aelbouhi0131-lang/BETABAKE_REV1.0/PCB/README.txt

# README – PCB Files

This folder contains two PCB versions

1. Routed PCB – The first PCB is the version I was working on, so I placed it here. However, it still contains some routing errors that need to be corrected.

2. PCB Before Routing – This is my copy of the PCB before routing. If you prefer to start from scratch, you can use this version and do the routing yourself.
