aelbouhi0131-lang/BETABAKE_REV1.0/BetaBake_REV_1.0_DRAFTSMAN.pdf

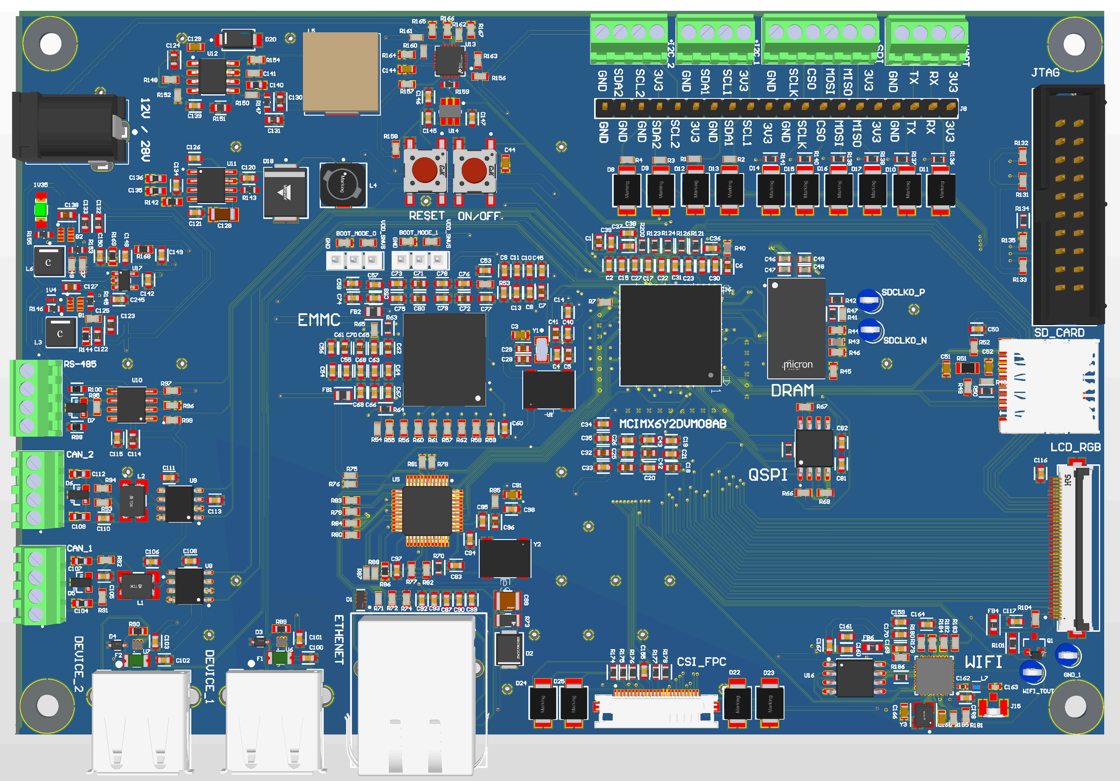
[picture p8: page 1]
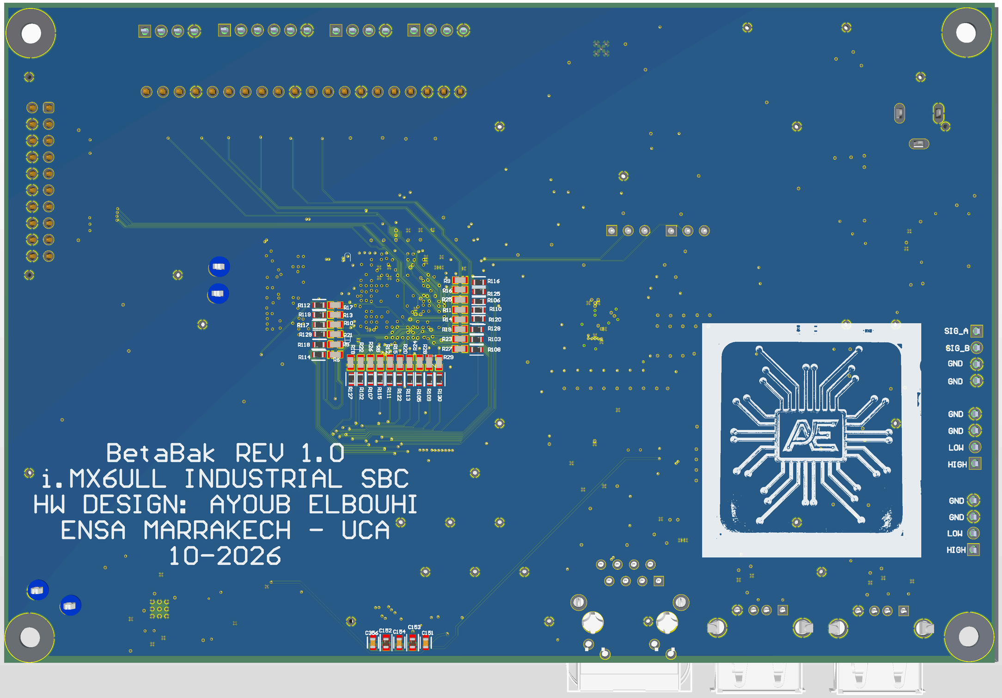
[picture p9: page 2]

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
TITLE

## TOP_LAYER

2

1

1

2

TITLE

## INNER_LAYER_1

2

1

1

2

TITLE

## PWR_LAYER

2

1

1

2

TITLE

## INNER_LAYER_2

2

1

1

2

TITLE

## BOTTOM_LAYER

2

1

1

2

Layer Stack Legend
Material

Total thickness: 1.63mm

Layer Top Overlay | ThicknessDielectric MaterialType
Gerber
GTO
GTS

TITLE

Surface MaterialTop Solder | 0.03mmSM-001
| 0.02mm
| 0.04mm
| 0.07mmPP-006
| 0.07mmPP-006
| 0.04mm
| 0.23mmCore-027

PbSn
CF-004
Prepreg
Prepreg
CF-004
Core
CF-004
Prepreg
Prepreg
CF-004
Core
CF-004
Prepreg
Prepreg
CF-004
Core
CF-004
Prepreg
Prepreg
CF-004
PbSn
Surface MaterialBottom Solder

Top Surface Finish
USB 2.0 (90 Diff) DDR3 Data (50-100)

GND (Top Layer high-speed return paths)

DDR3 Fly-by Routing (Address, Command, Control), QSPI Flash (Clk, IO)0.04mm 0.07mmPP-006
0.07mmPP-006
0.04mm
0.23mmCore-027
0.04mm
0.07mmPP-006
0.07mmPP-006
0.04mm
0.23mmCore-027
0.04mm
0.07mmPP-006
0.07mmPP-006
0.04mm
0.02mm
0.03mmSM-001

Int4 PWR

Int5 GND (Shielding between L4 and L6)

Int6 eMMC High-Speed Data Lines (8-bit bus), SDIO/peripherals

Int7 GND

Escapes, non-critical tracks, decoupling capacitor vias Bottom Surface Finish

Bottom Overlay

Legend
Solder Mask
Surface Finish
Signal
Dielectric
Dielectric
Internal PlaneGP1
Dielectric
Signal
Dielectric
Dielectric
Signal
Dielectric
Signal
Dielectric
Dielectric
Signal
Dielectric
Internal PlaneGP2
Dielectric
Dielectric
Signal
Surface Finish
Solder Mask
Legend

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
