aelbouhi0131-lang/BETABAKE_REV1.0/Images/3D/IMAGES ALTIUM/BetaBake_REV_1.0.png

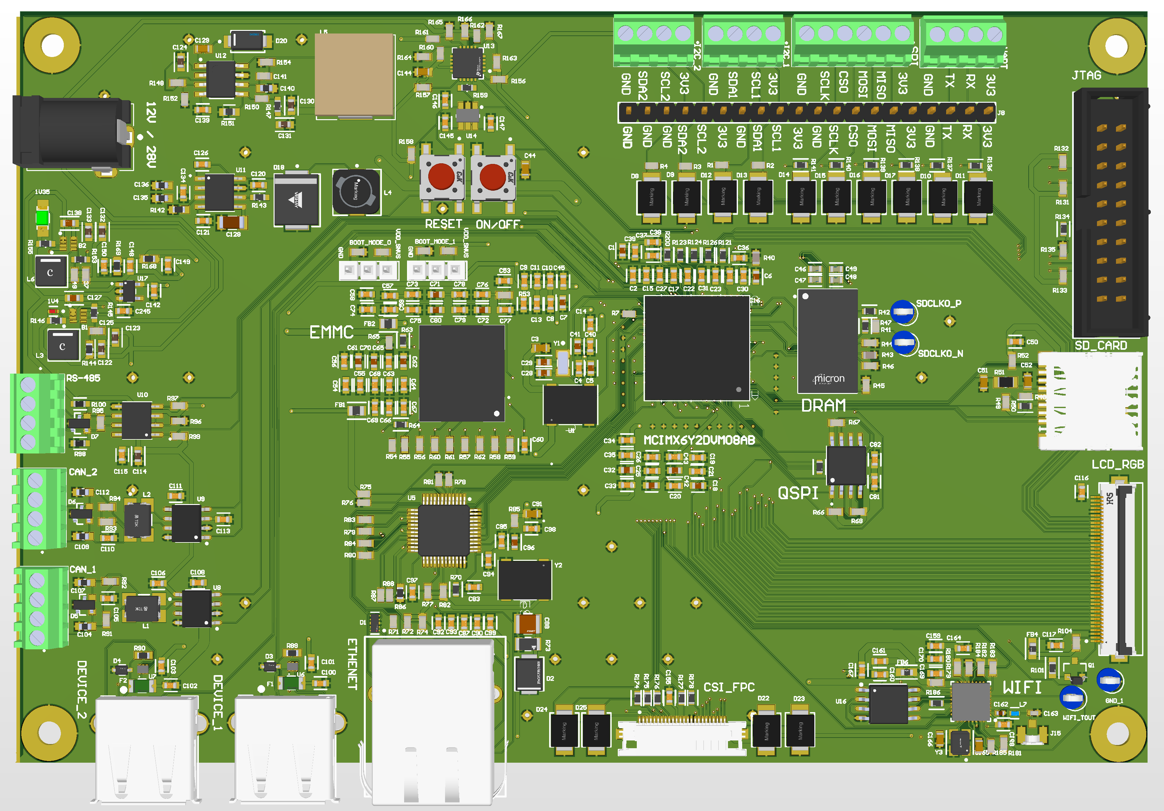
Images/3D/IMAGES ALTIUM/BetaBake_REV_1.0.png
