aelbouhi0131-lang/BETABAKE_REV1.0/BetaBake_REV_1.0.pdf

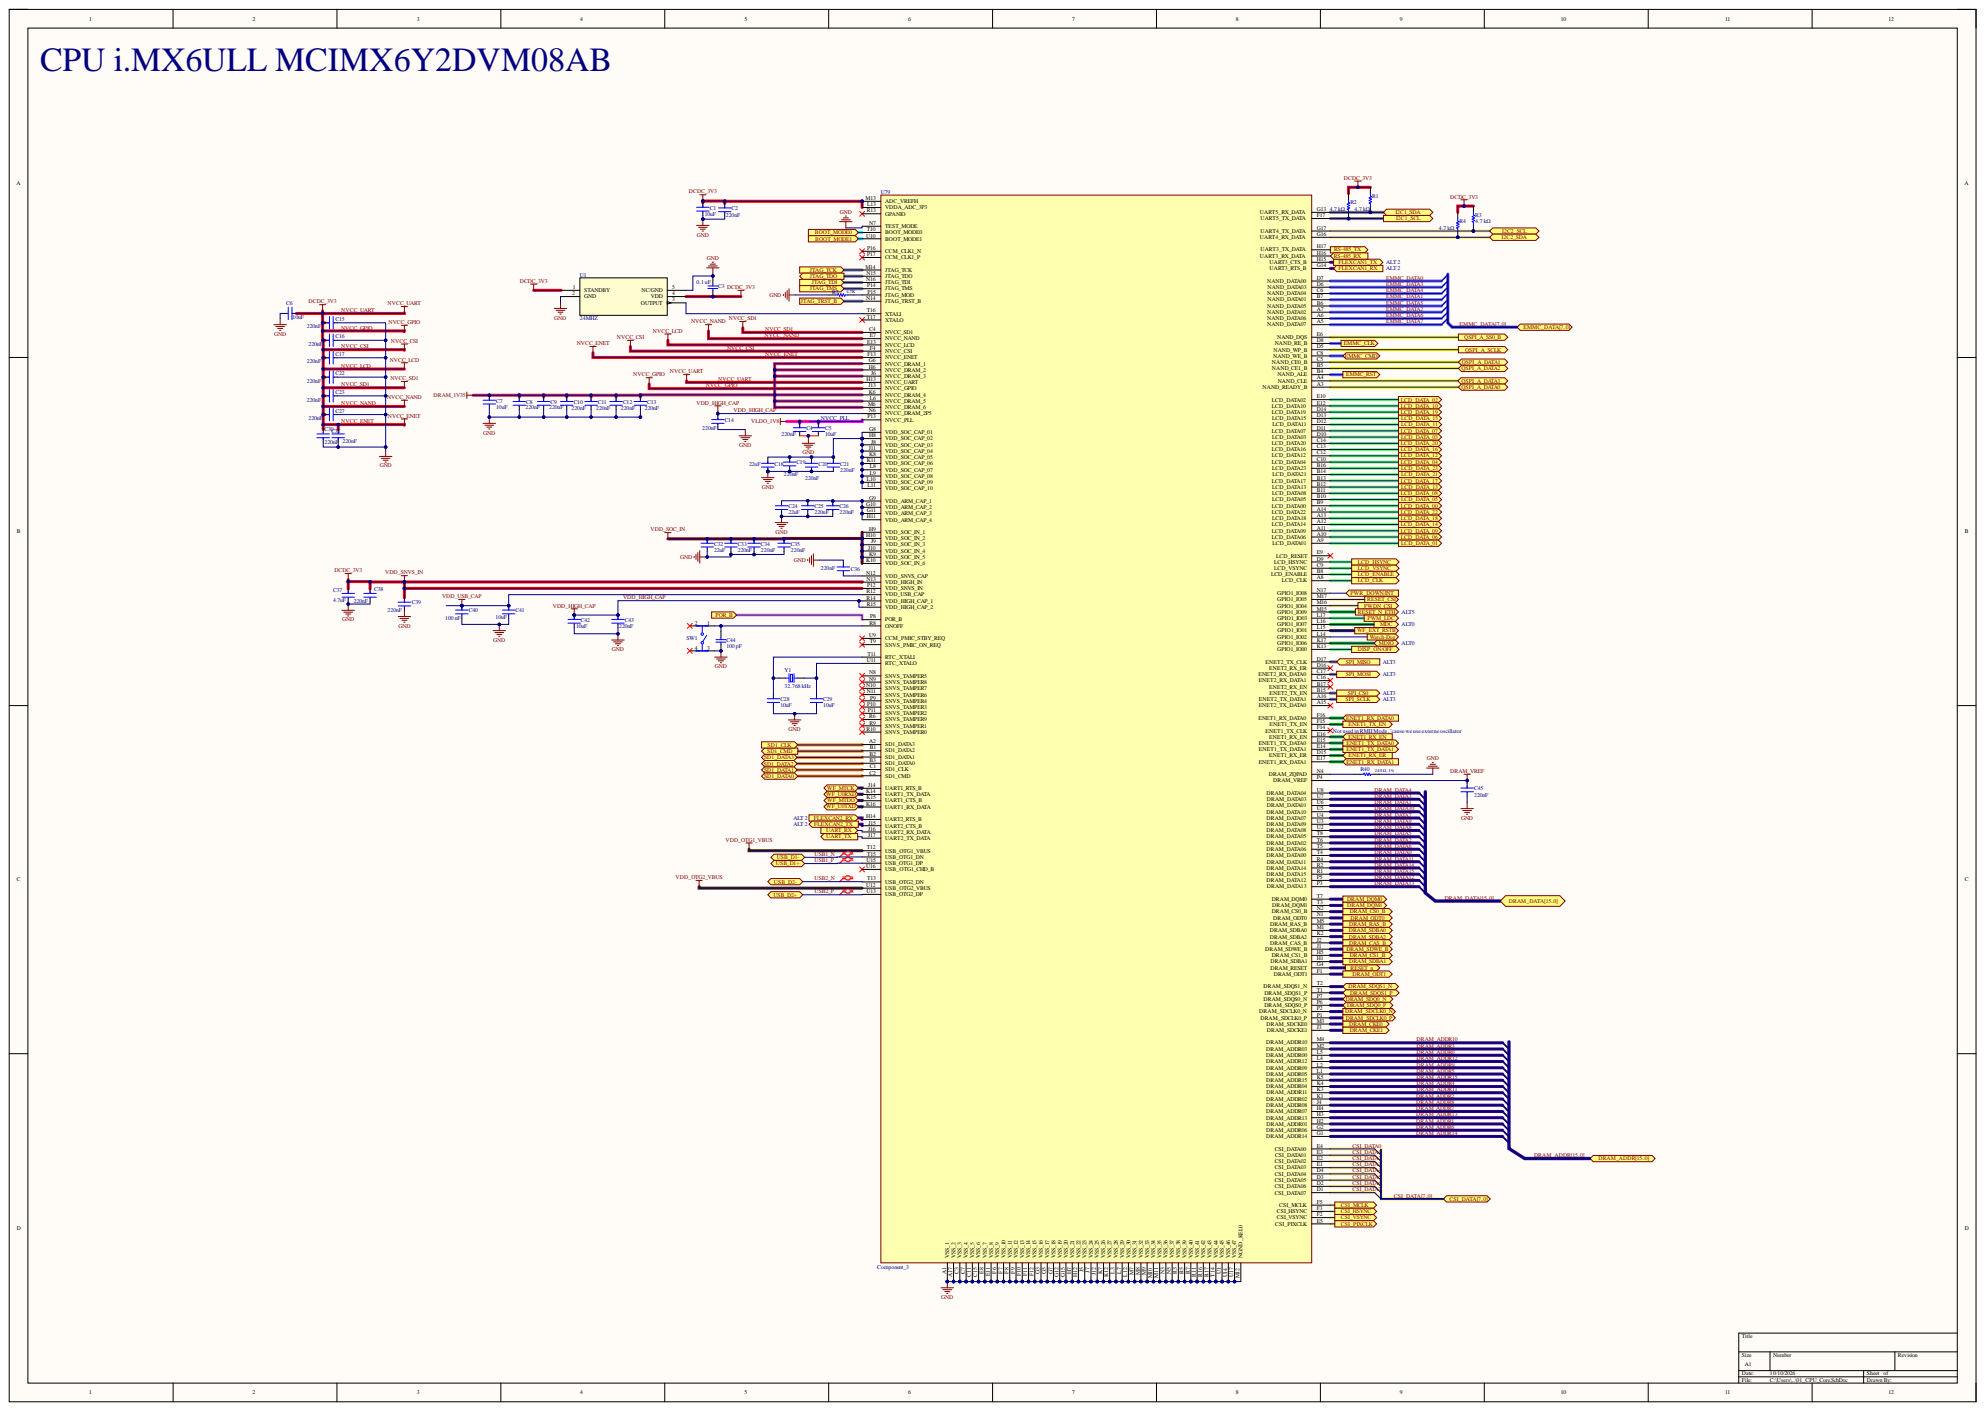
[picture p12: page 1]

S B _ D D _ H IGH_ C AP | R 1 4

E 3 C S I _ D ATA E 2 C S I _ D ATA | 1 2 3 5 6 C S I _ D ATA [7 . . 0 ]

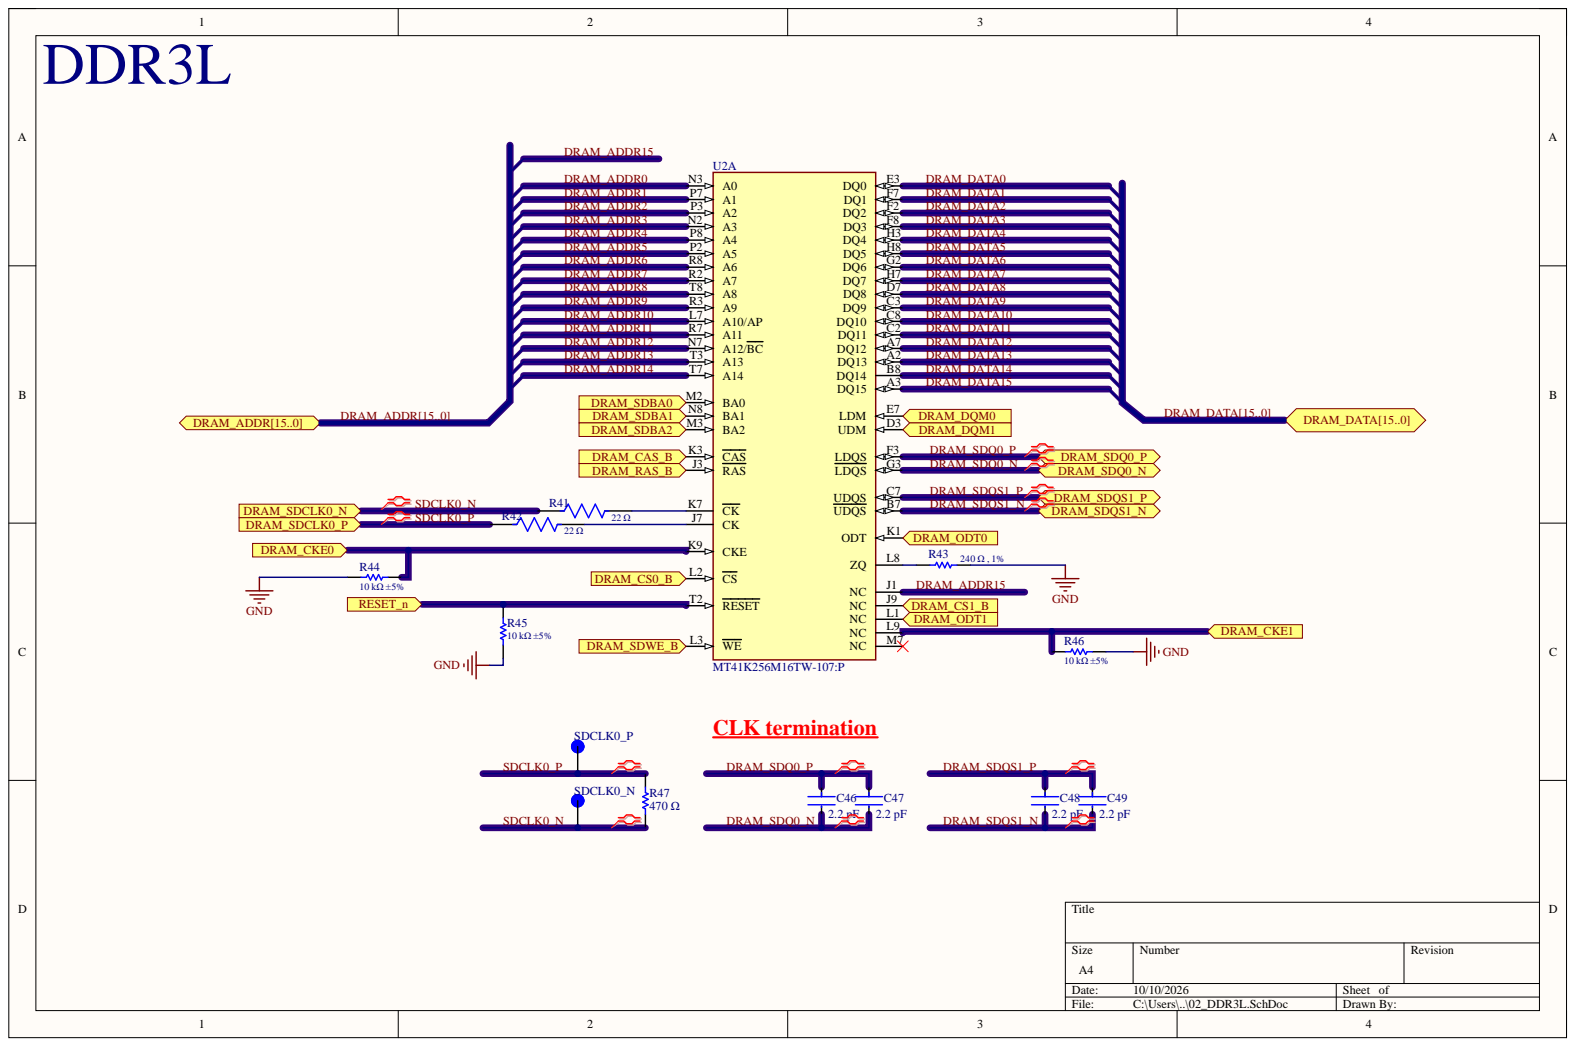
[picture p13: page 2]

Size A4 | Number | Revision

Date: 10/10/2026 | Sheet of
File: C:\Users\..\02_DDR3L.SchDoc | Drawn By:

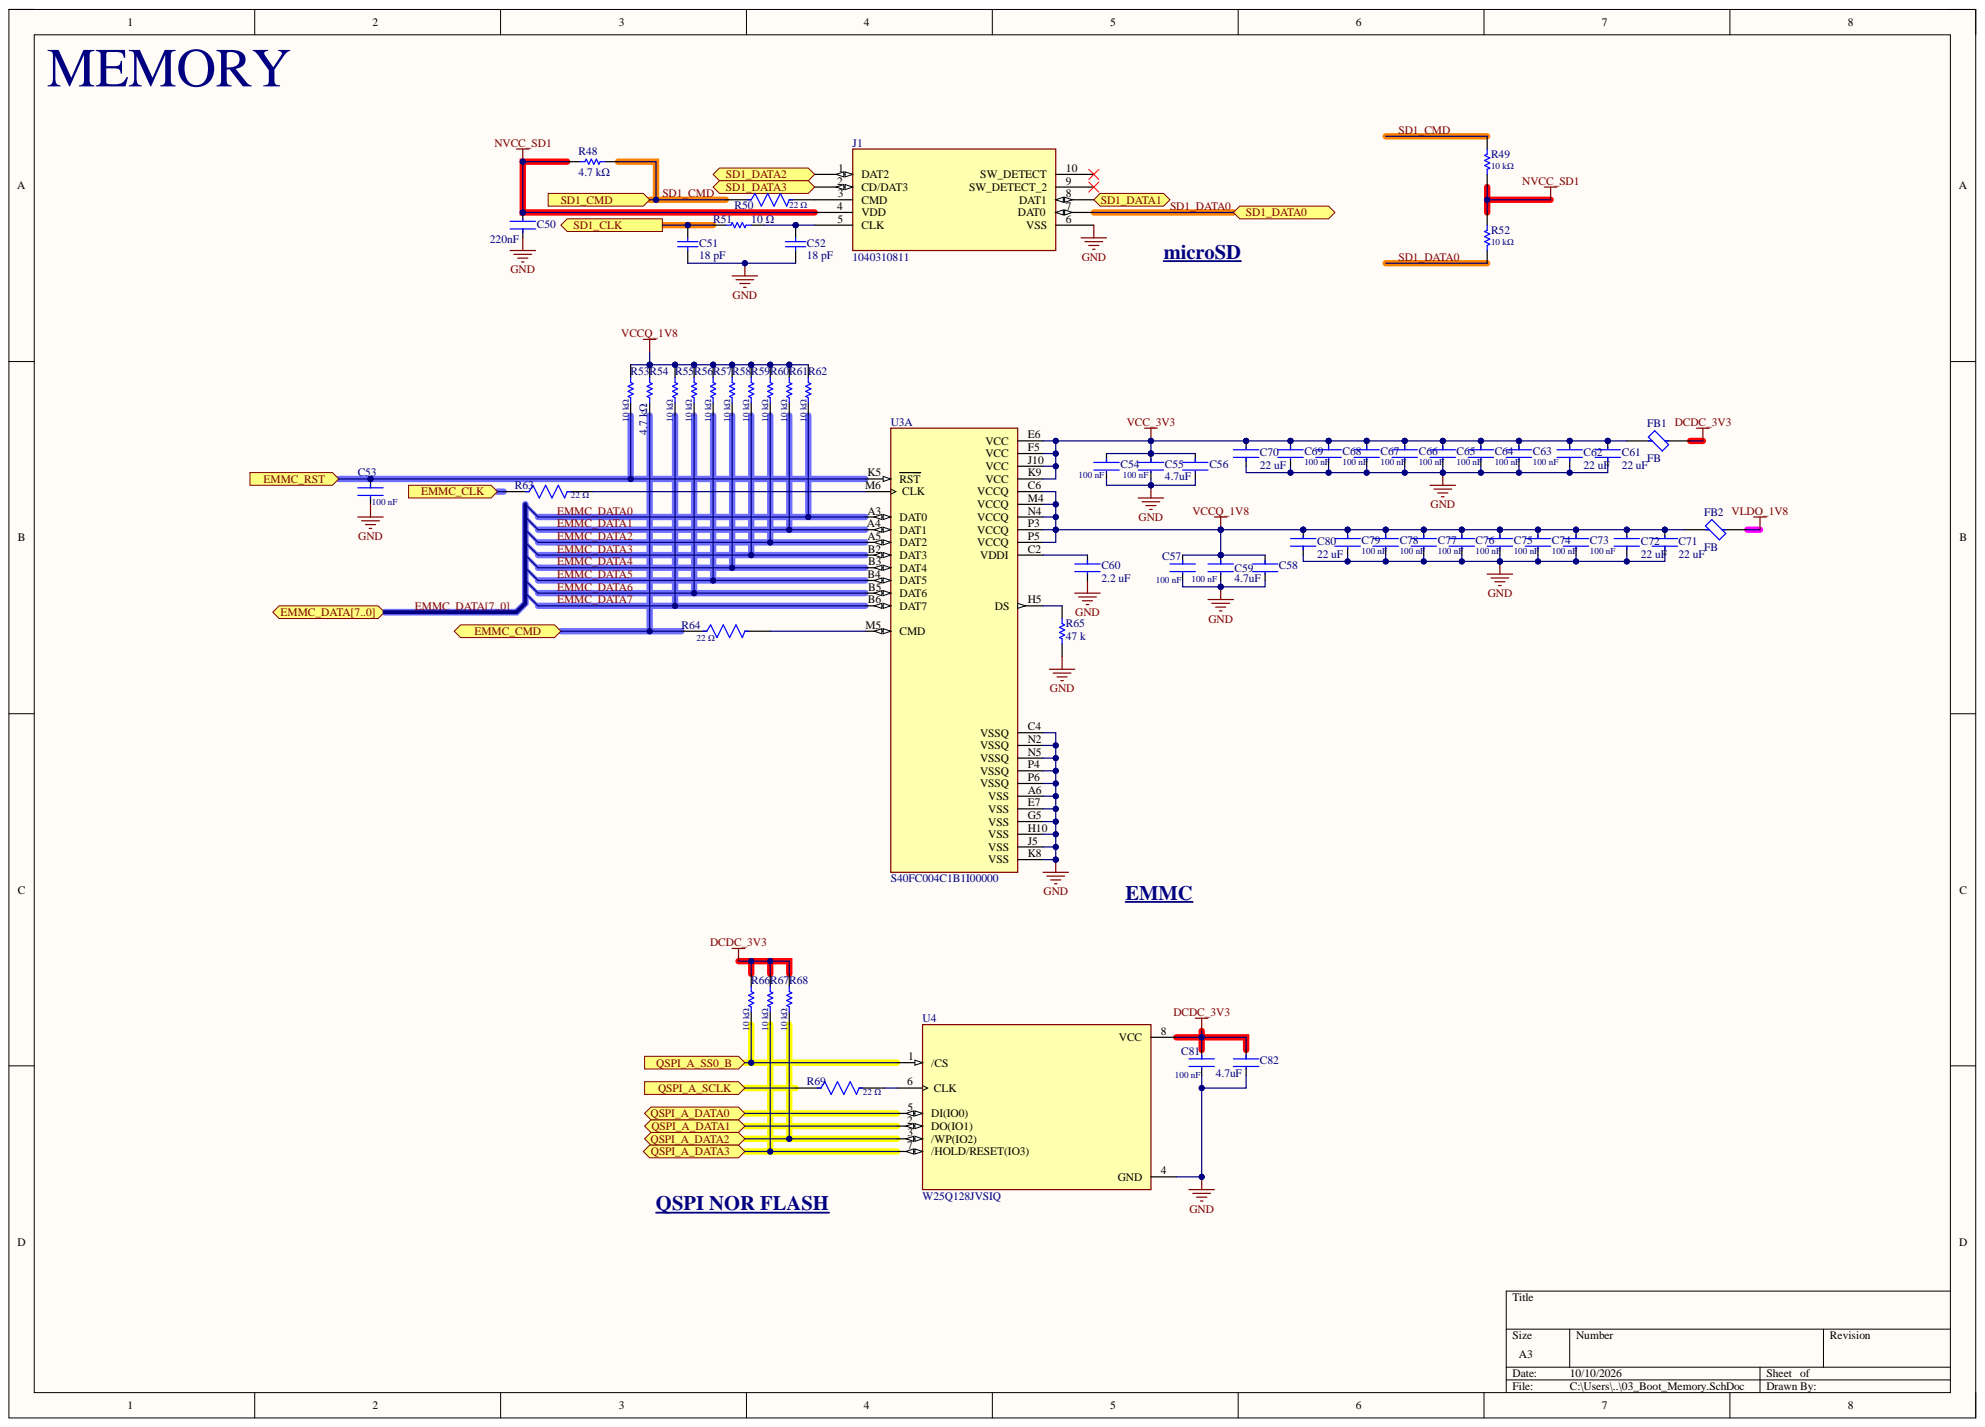
[picture p14: page 3]

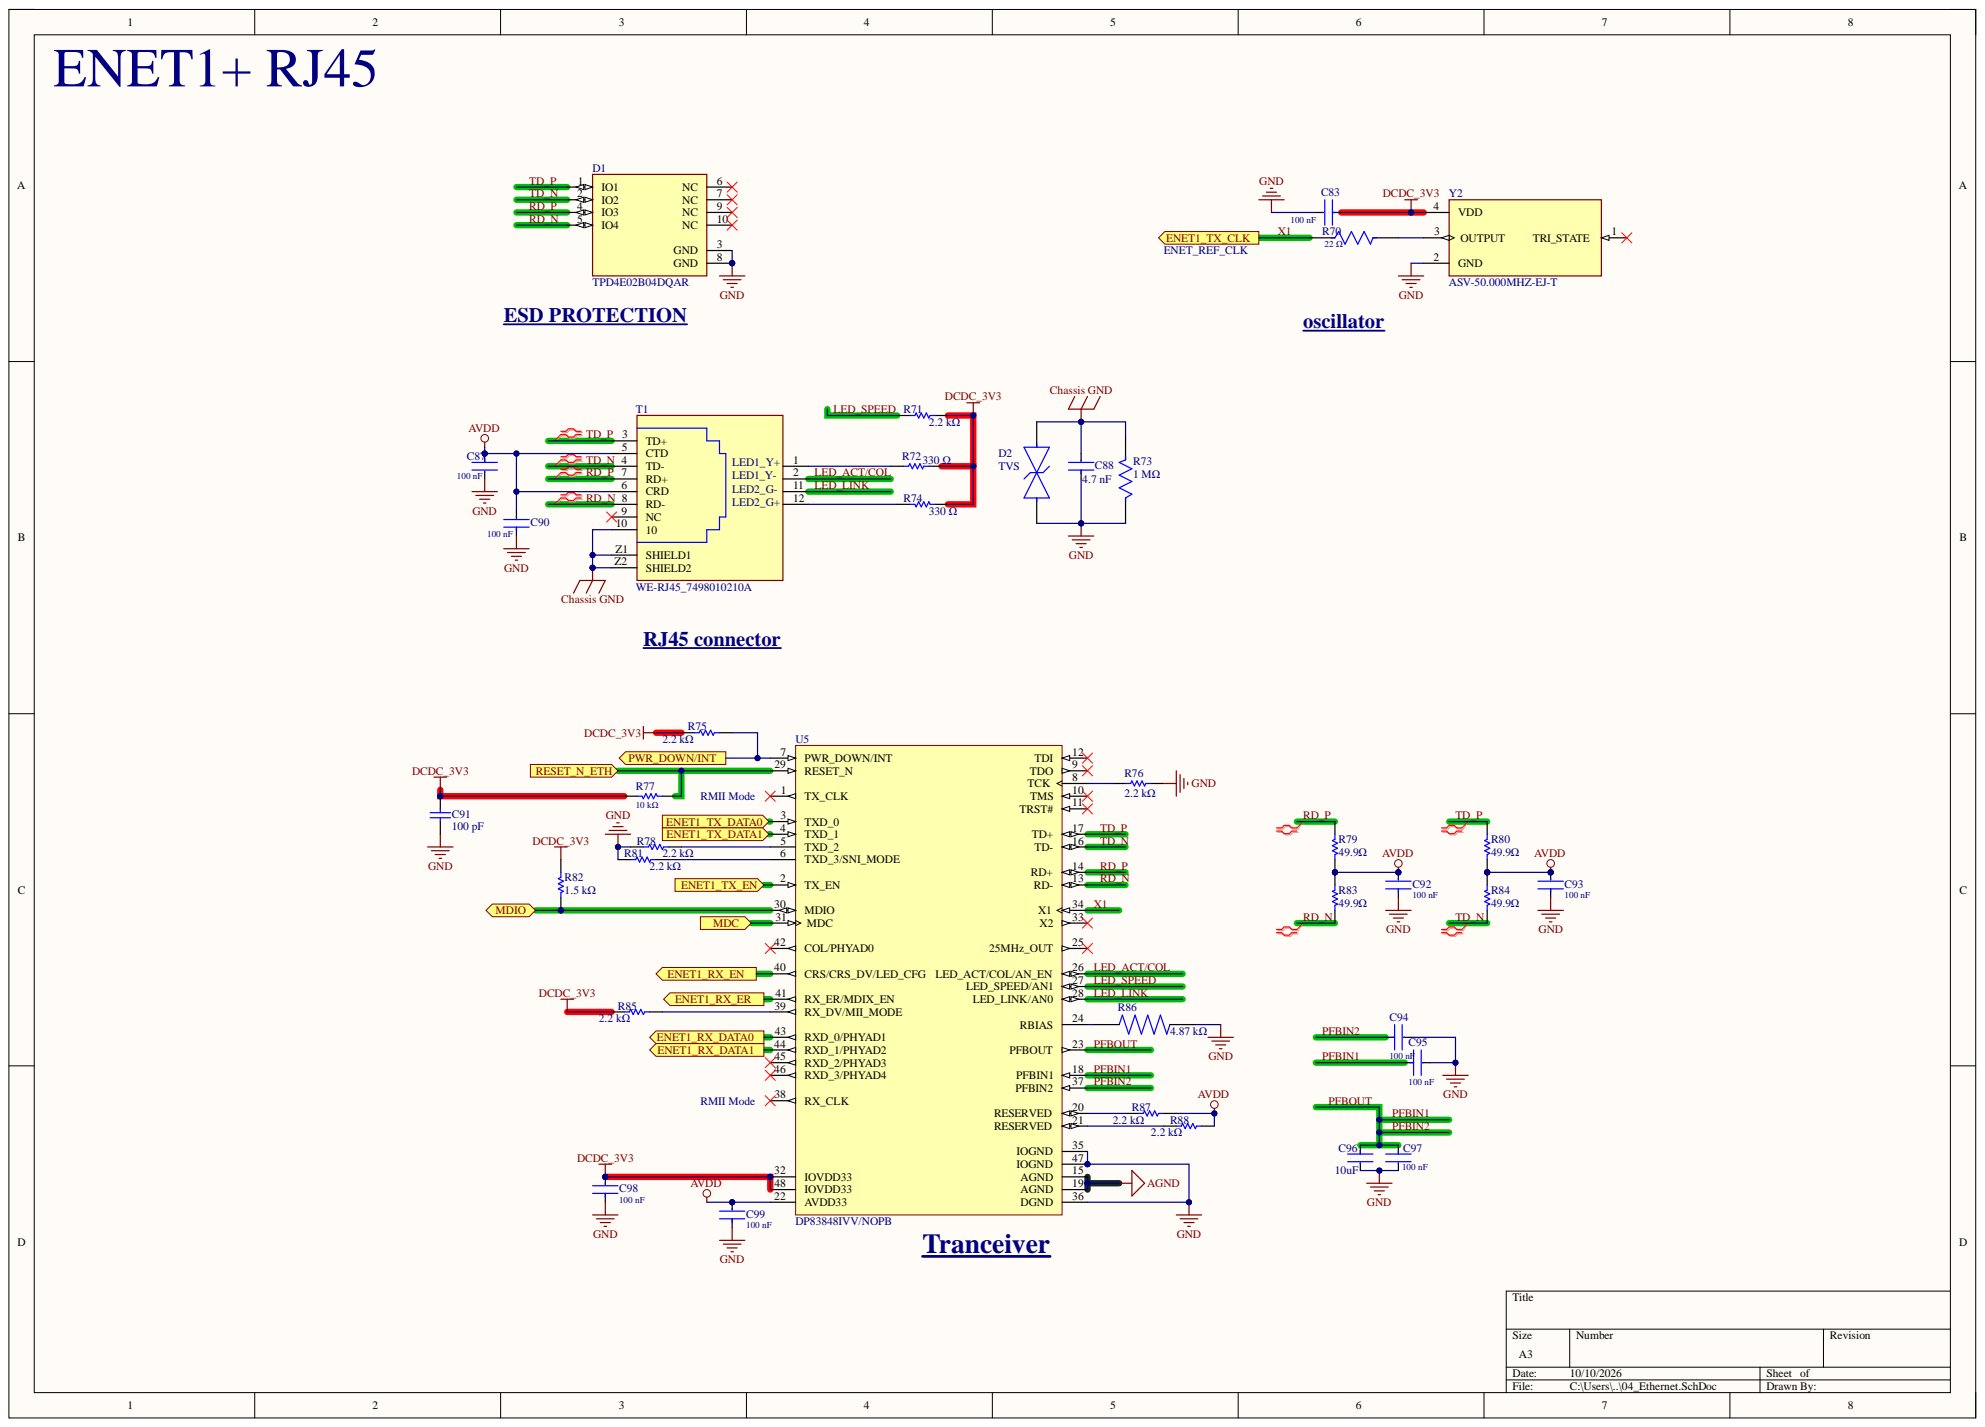
[picture p15: page 4]

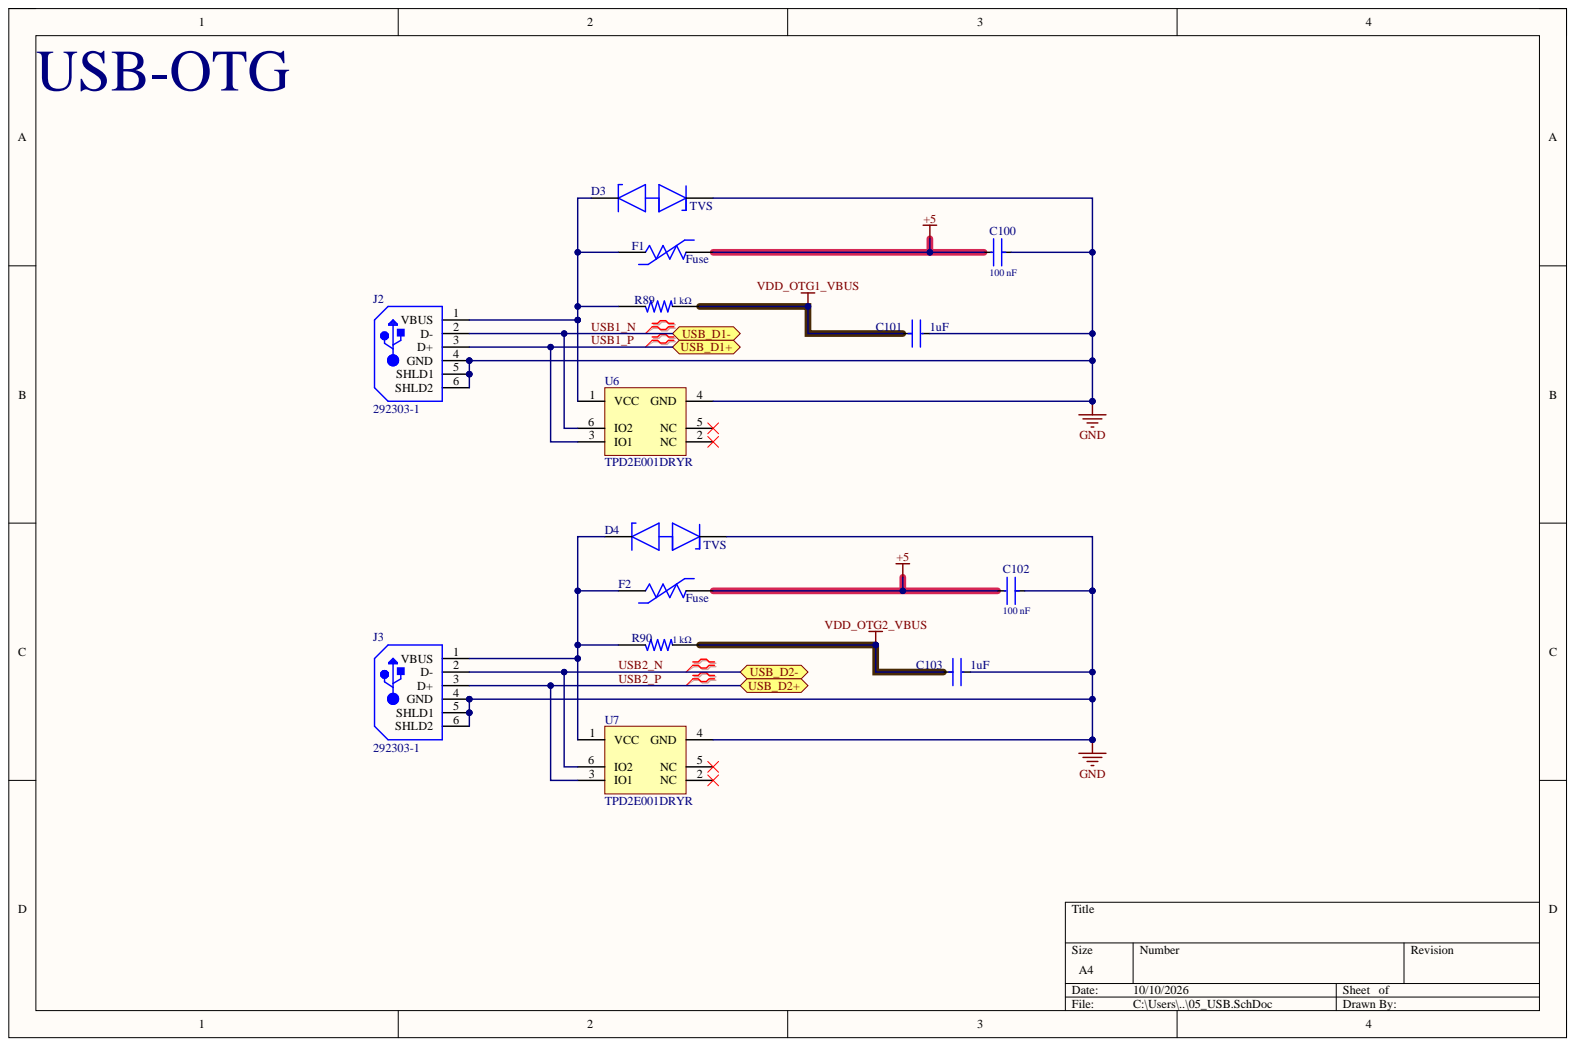
[picture p16: page 5]

Size A4 | Number | Revision

Date: 10/10/2026 | Sheet of
File: C:\Users\..\05_USB.SchDoc | Drawn By:

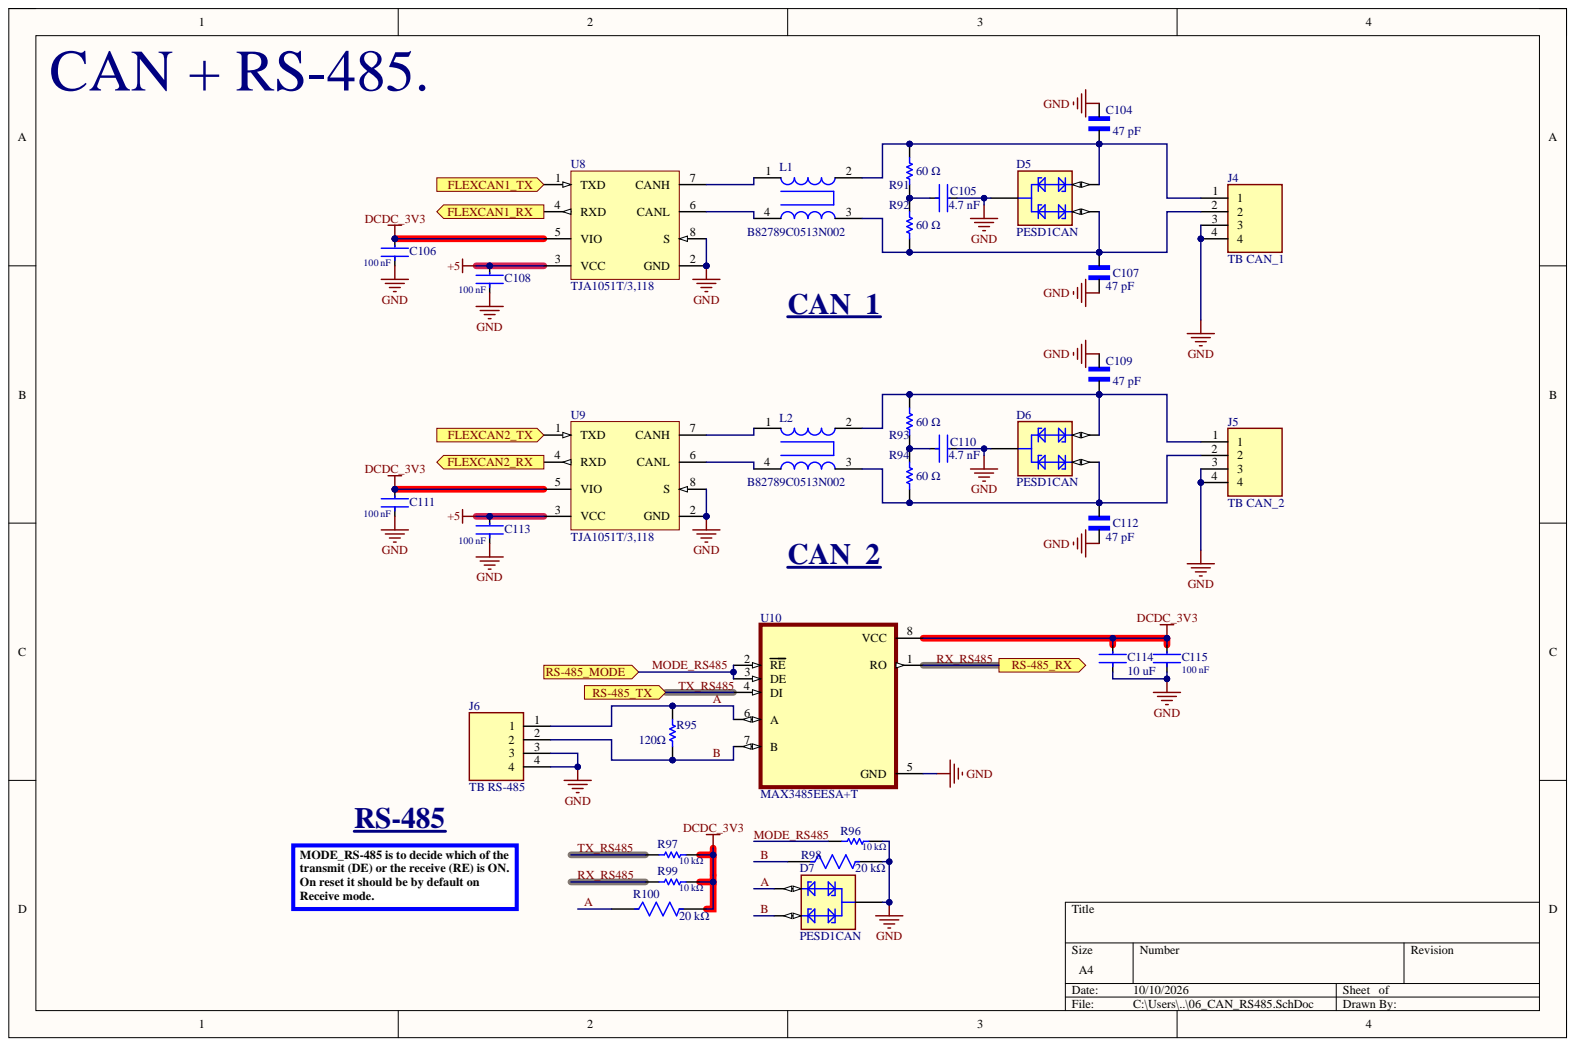
[picture p17: page 6]

2 2
3 3

MODE_RS-485 is to decide which of the
transmit (DE) or the receive (RE) is ON.
On reset it should be by default on
Receive mode.

Size A4 | Number | Revision

Date: 10/10/2026 | Sheet of
File: C:\Users\..\06_CAN_RS485.SchDoc | Drawn By:

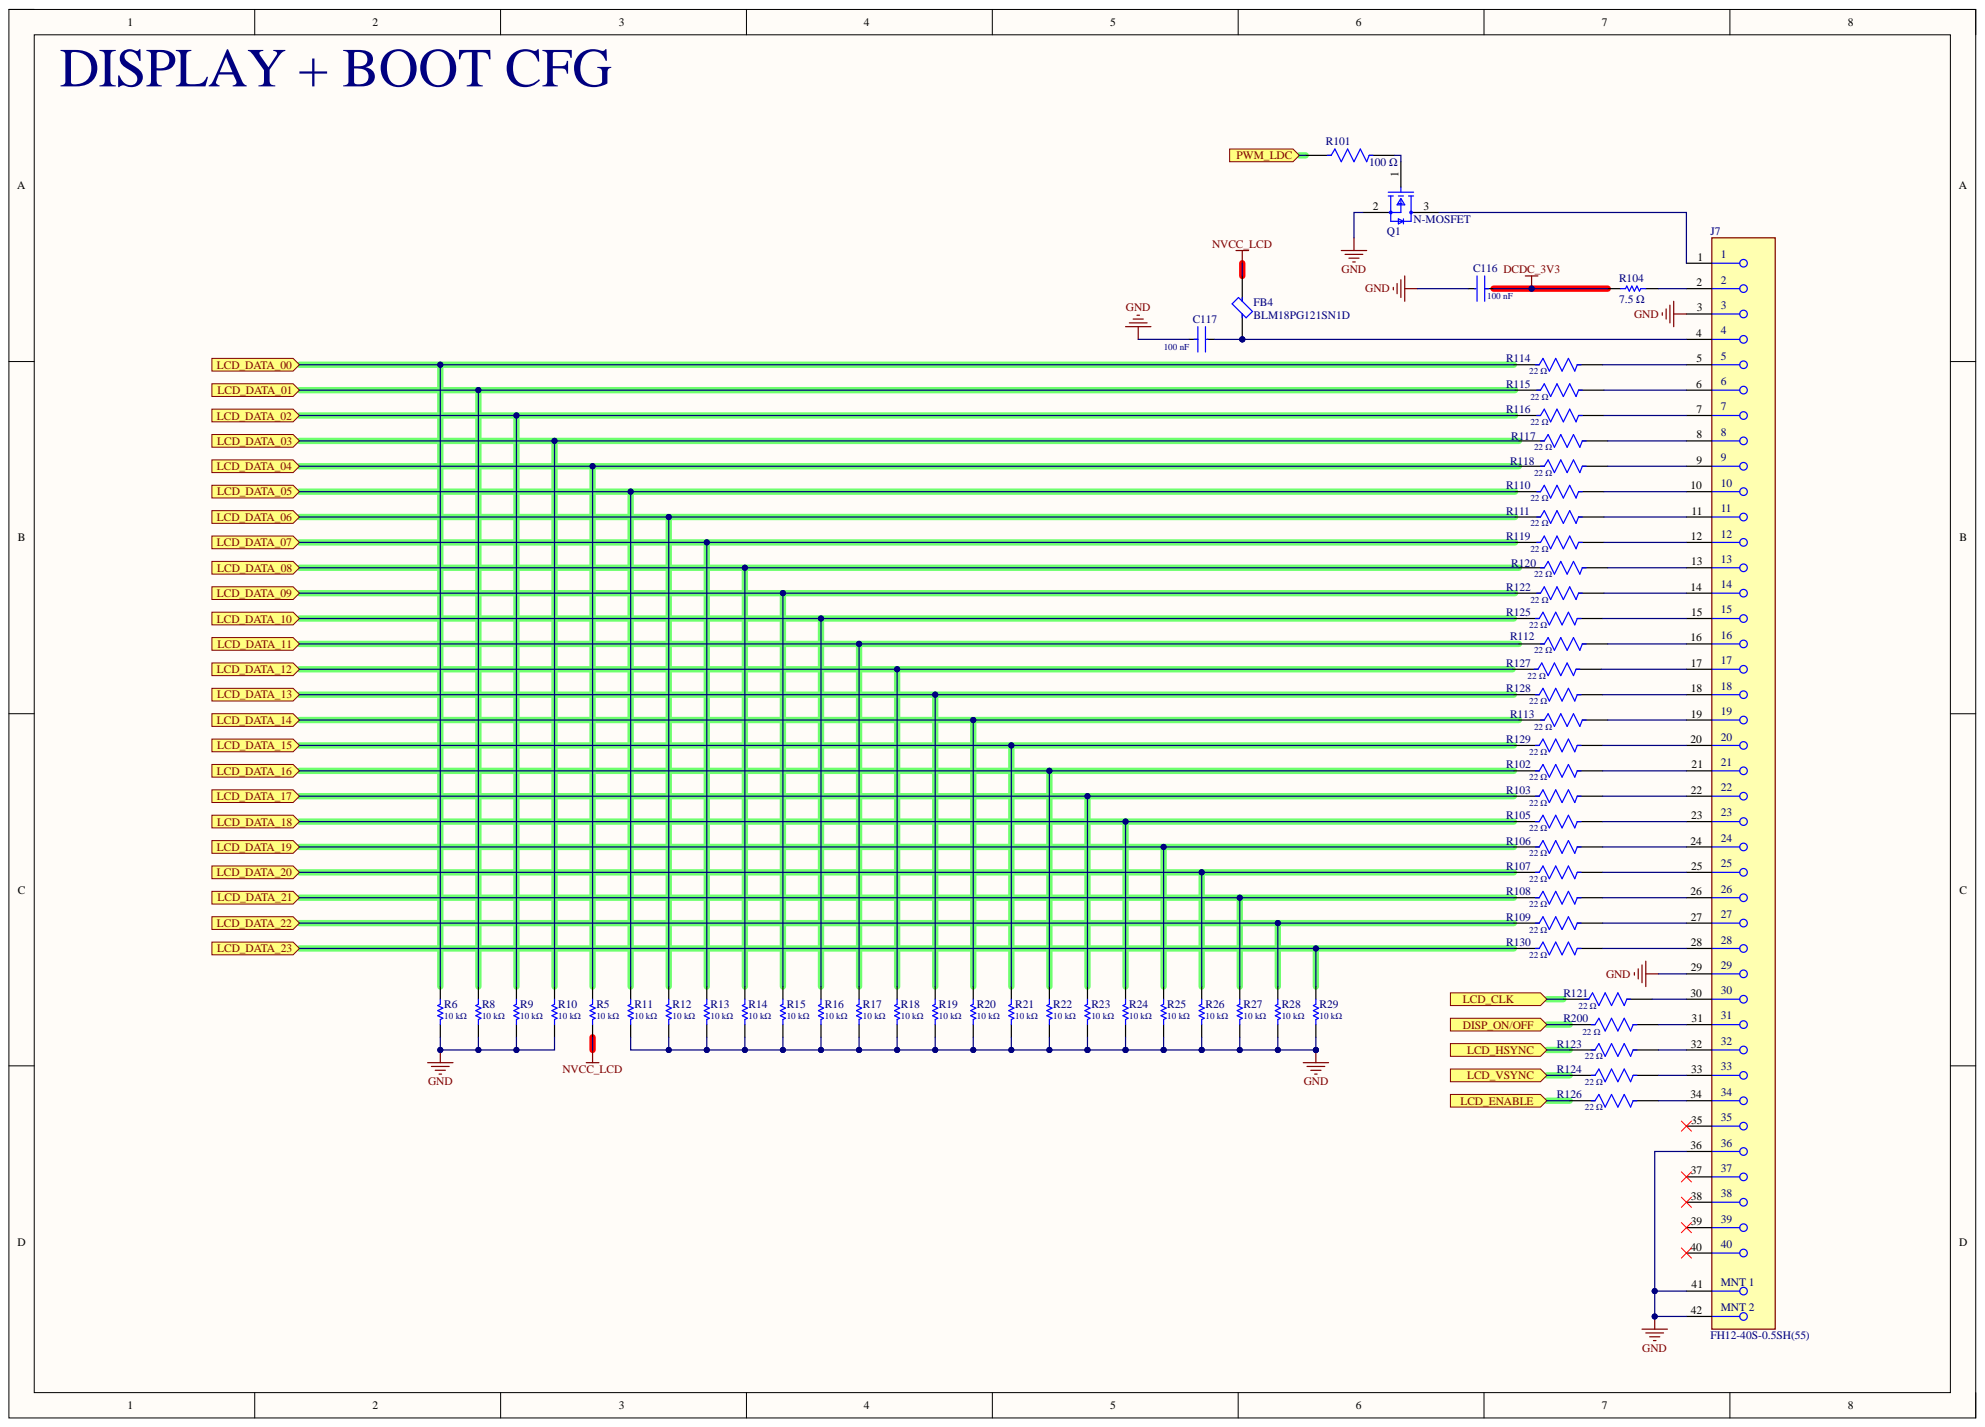
[picture p18: page 7]

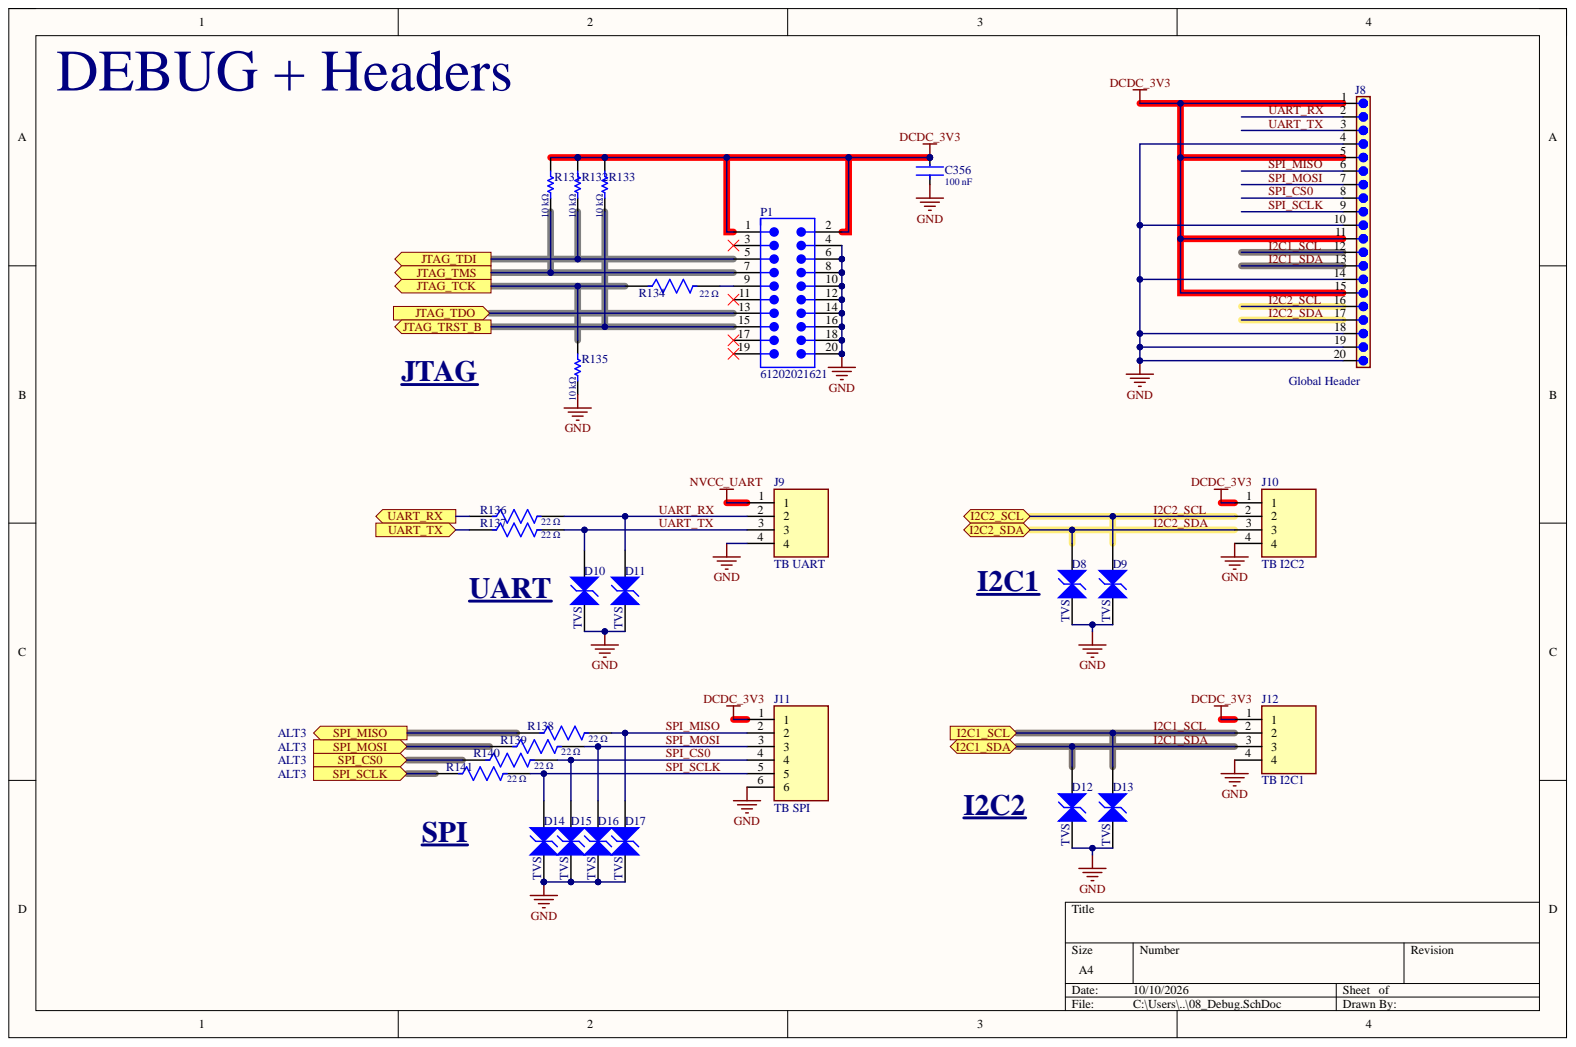
[picture p19: page 8]

UART_RX UART_TX | 2 3 4

I2C1_SCL 12 I2C1_SDA 13 14

Size A4 | Number | Revision

Date: 10/10/2026 | Sheet of
File: C:\Users\..\08_Debug.SchDoc | Drawn By:

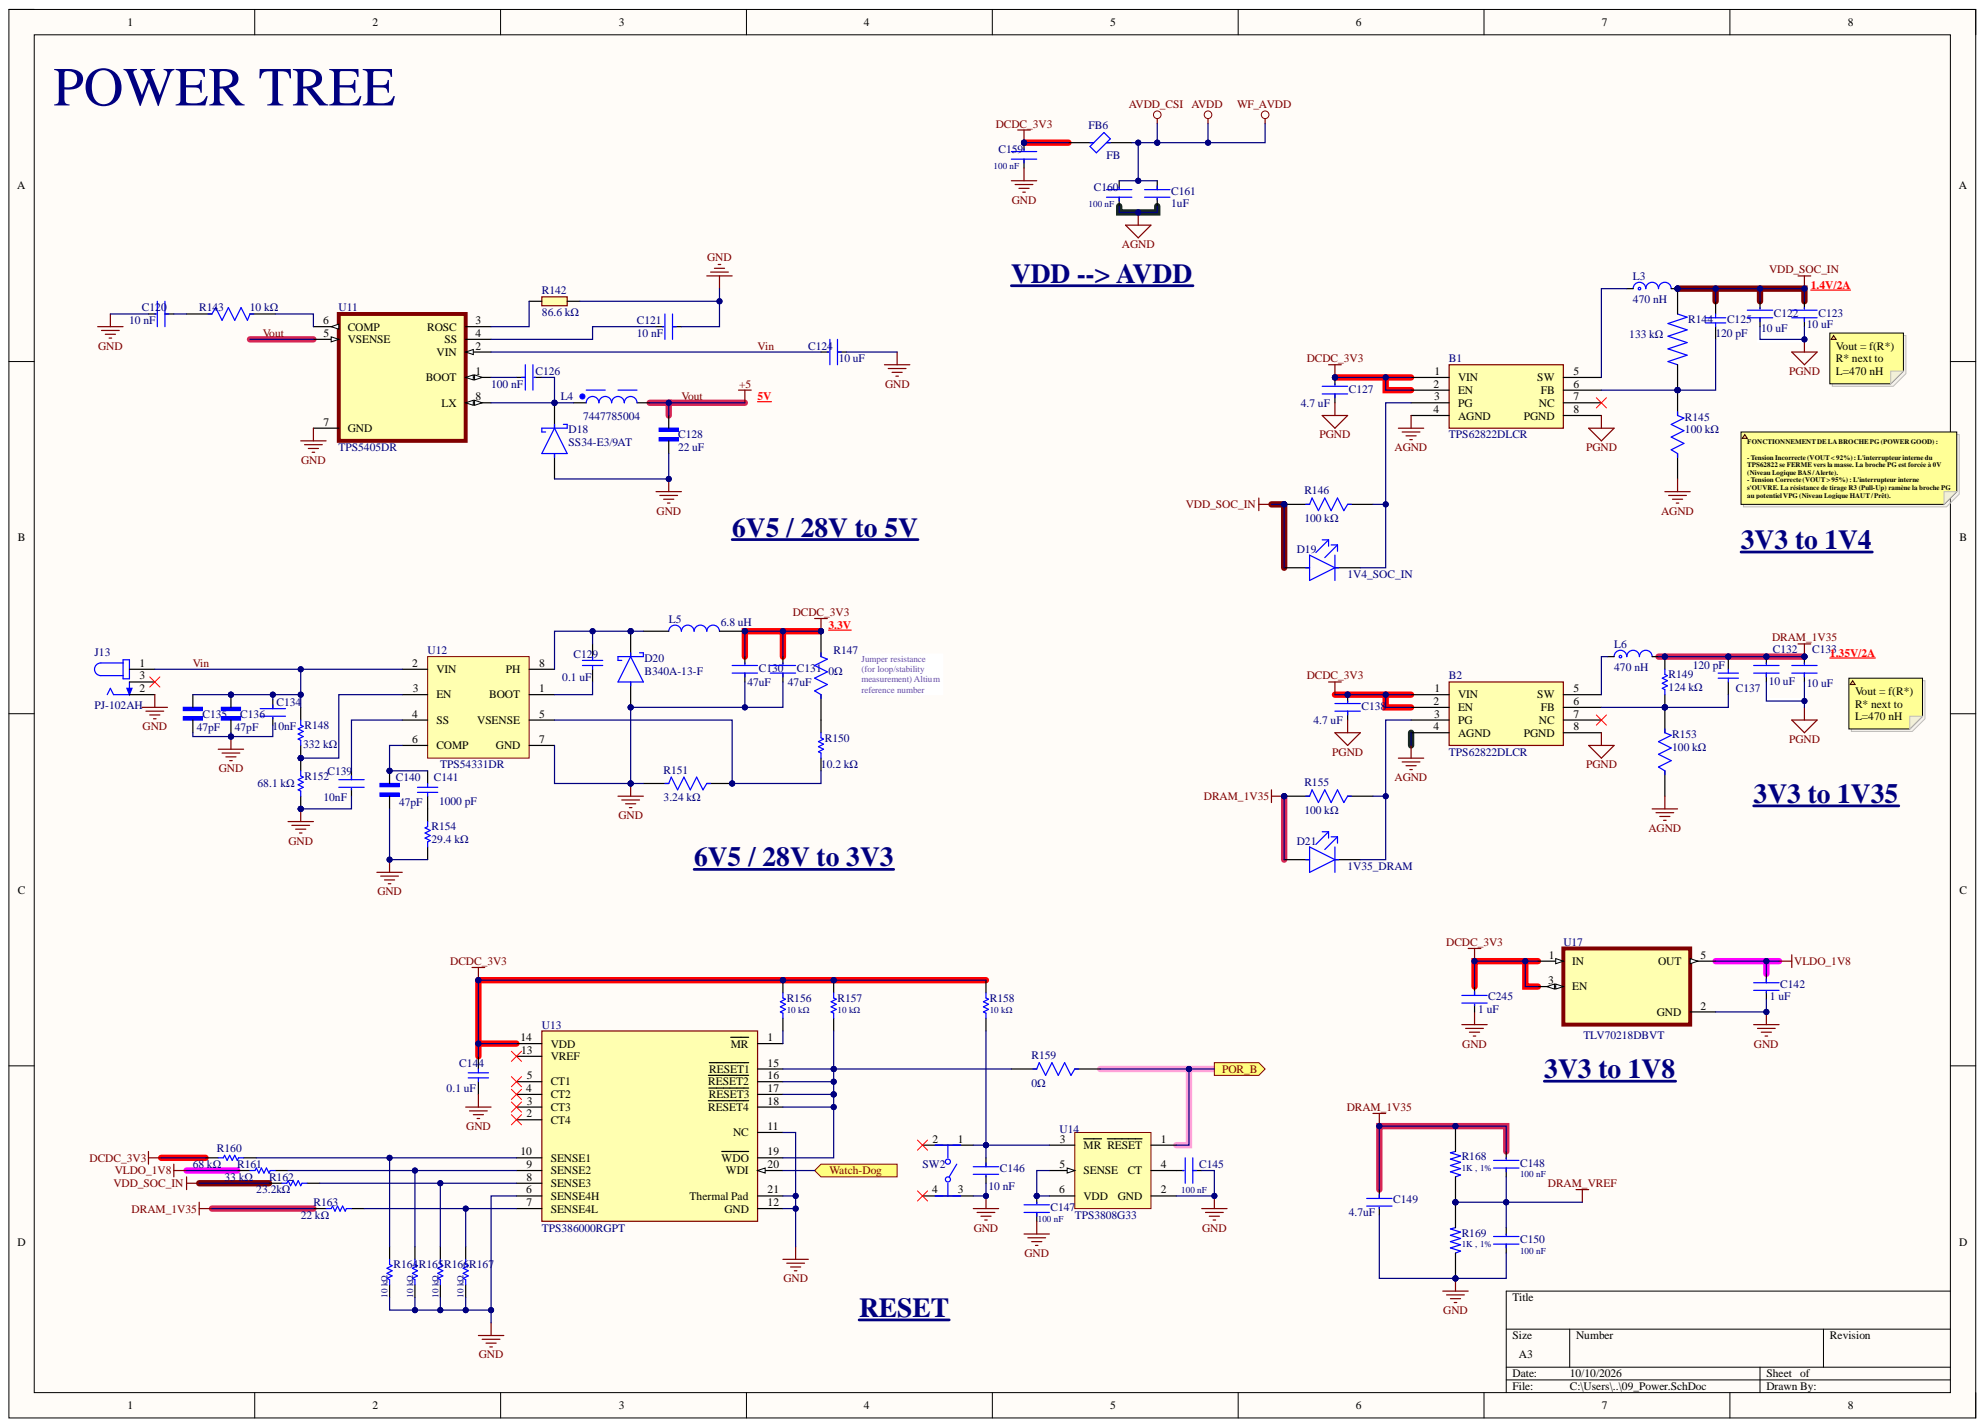
[picture p20: page 9]

AGND 4

FONCTIONNEMENT DELA BROCHE PG (POWER GOOD) :

- Tension Incorrecte (VOUT< 92%) : L'interrupteur interne du
TPS62822 se FERME vers la masse. La broche PG est forcée à 0V
(Niveau Logique BAS / Alerte).
- Tension Correcte (VOUT> 95%) : L'interrupteur interne
s'OUVRE. La résistance de tirage R3 (Pull-Up) ramène la broche PG
au potentiel VPG (Niveau Logique HAUT/ Prêt).

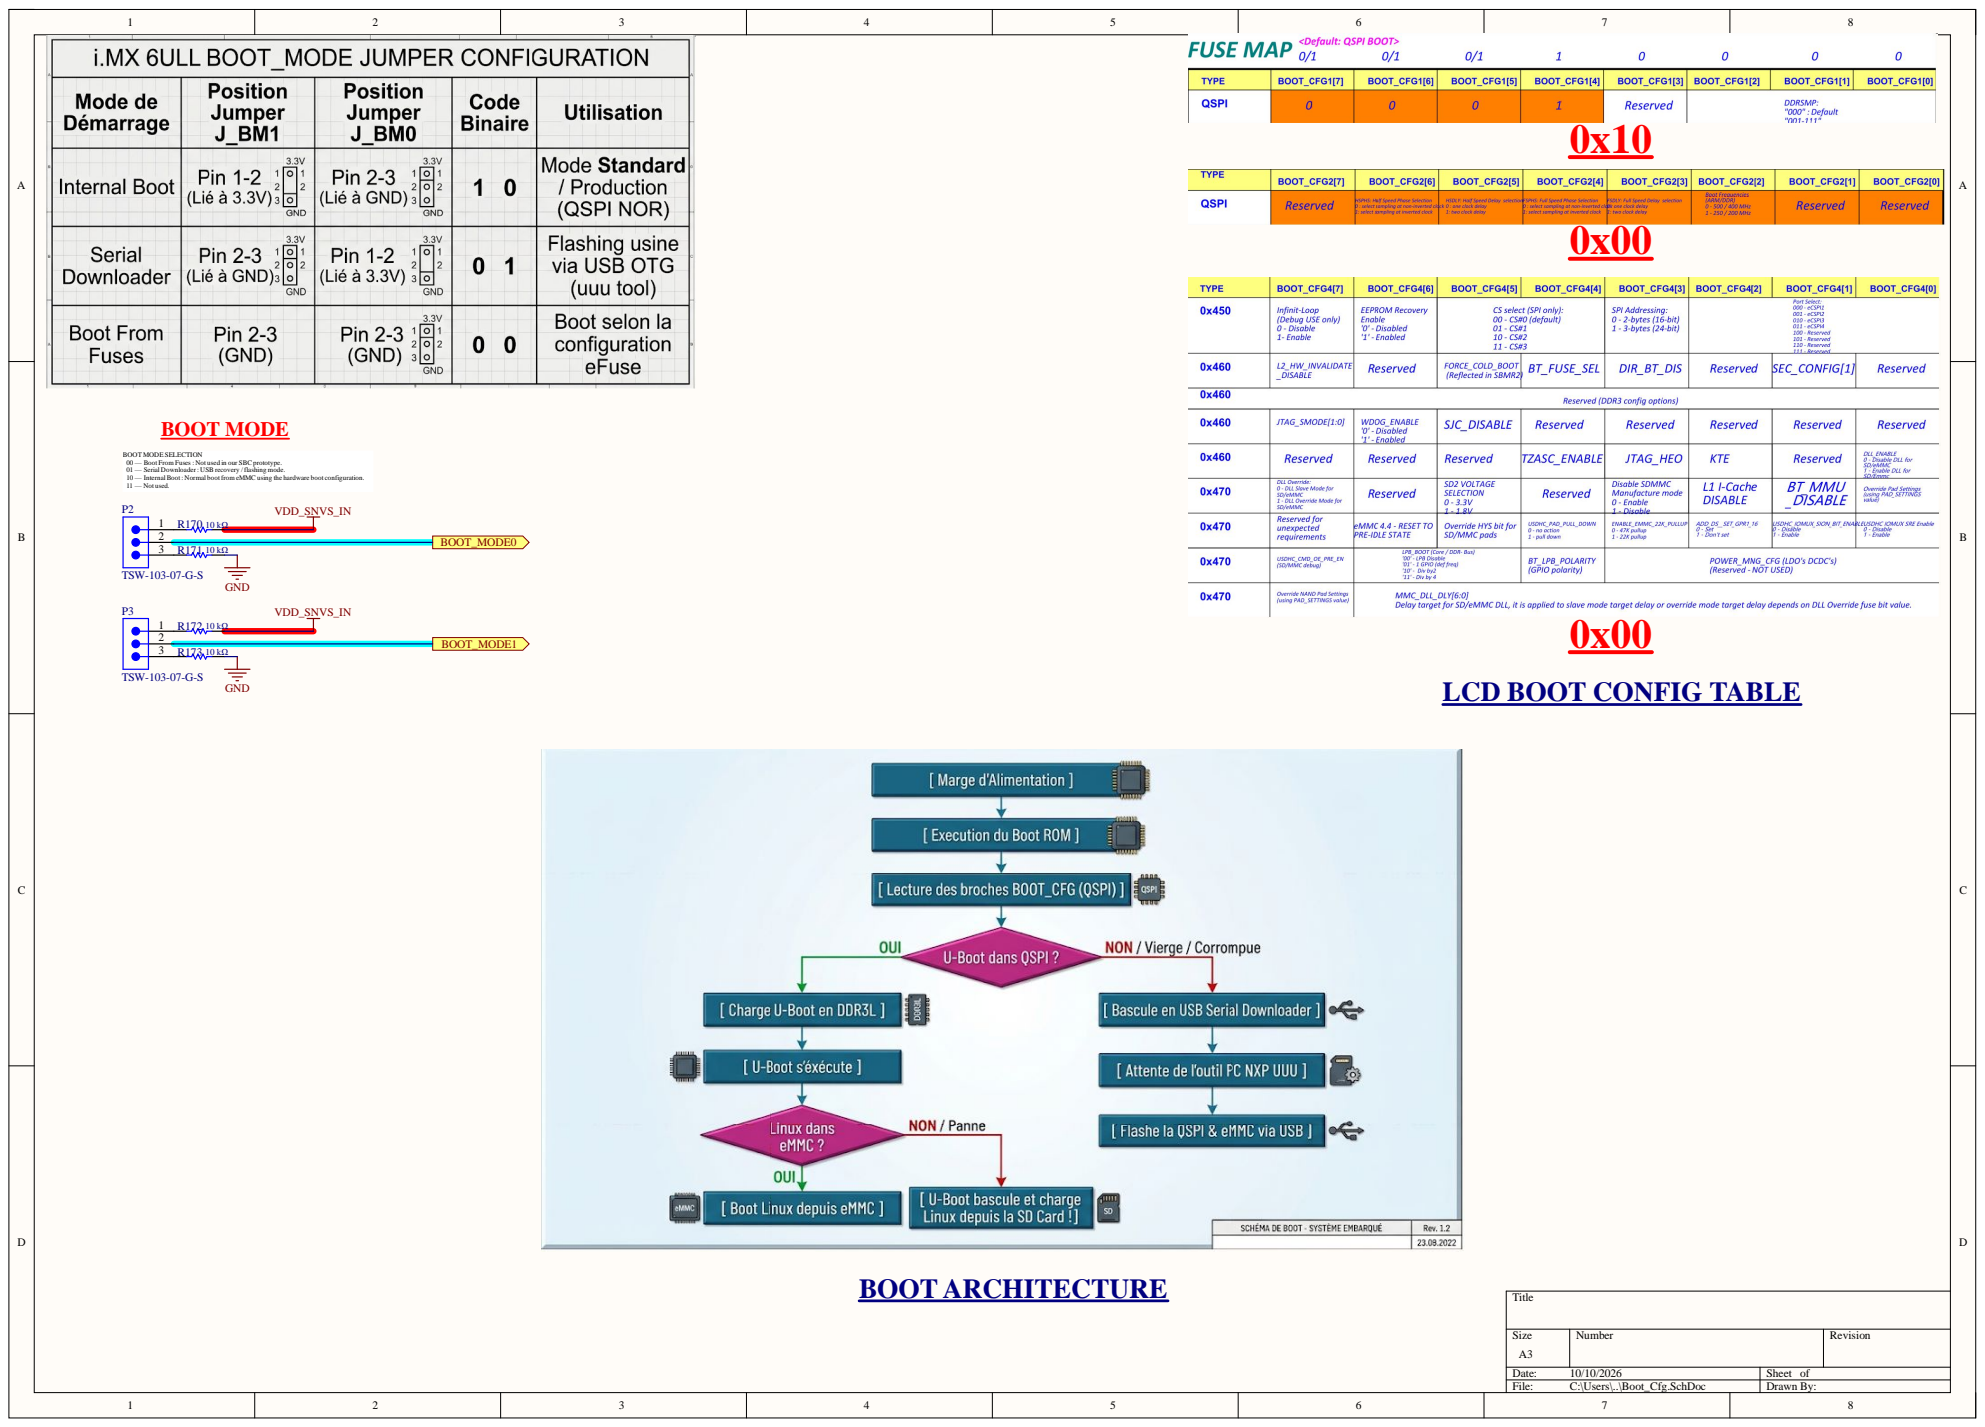
[picture p21: page 10]

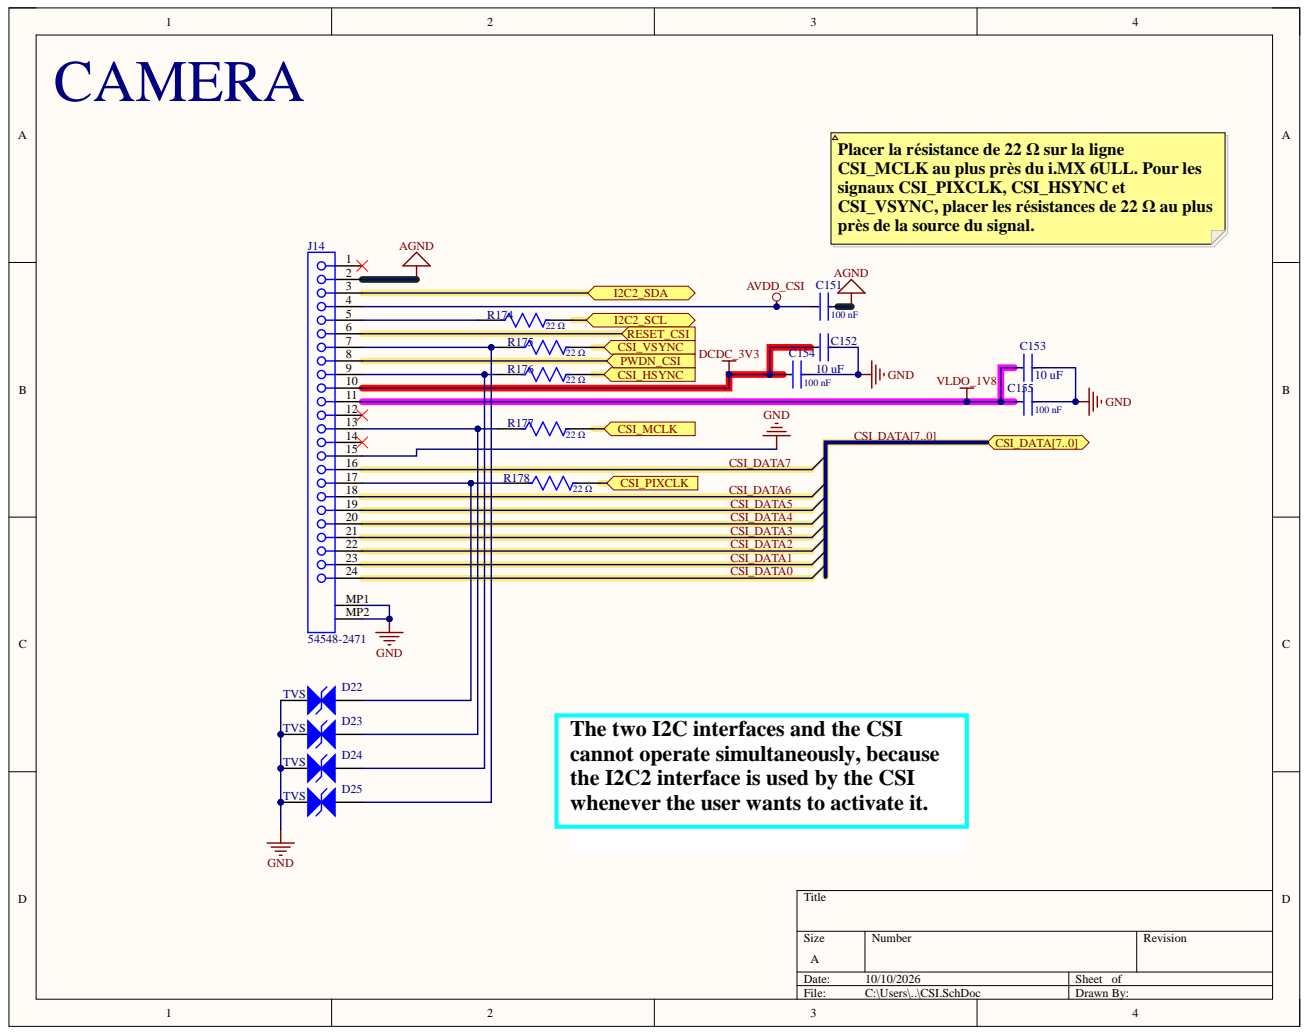
[picture p22: page 11]

Placer la résistance de 22 Ω sur la ligne
CSI_MCLK au plus près du i.MX 6ULL. Pour les
signaux CSI_PIXCLK, CSI_HSYNC et
CSI_VSYNC, placer les résistances de 22 Ω au plus
près de la source du signal.

10
11
12

16 | CSI_DATA7
17 18 | 22 Ω CSI_PIXCLK R178 CSI_DATA6

19 | CSI_DATA5
20 | CSI_DATA4
21 | CSI_DATA3
22 | CSI_DATA2
23 | CSI_DATA1
24 | CSI_DATA0

MP1
MP2

The two I2C interfaces and the CSI
cannot operate simultaneously, because
the I2C2 interface is used by the CSI
whenever the user wants to activate it.

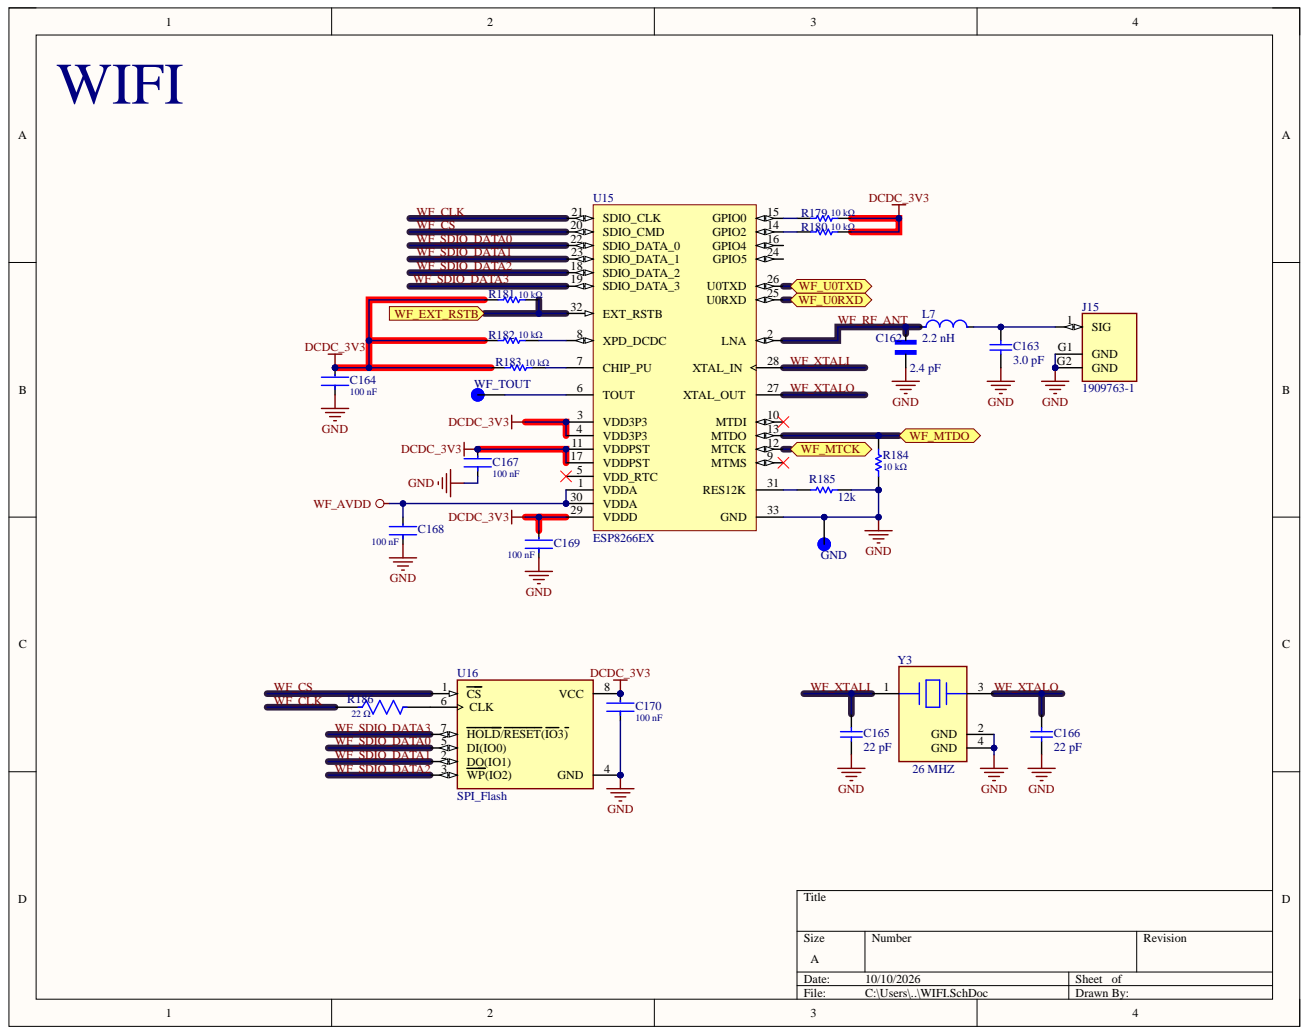
[picture p23: page 12]

VDD3P3 4

VDDPST 17

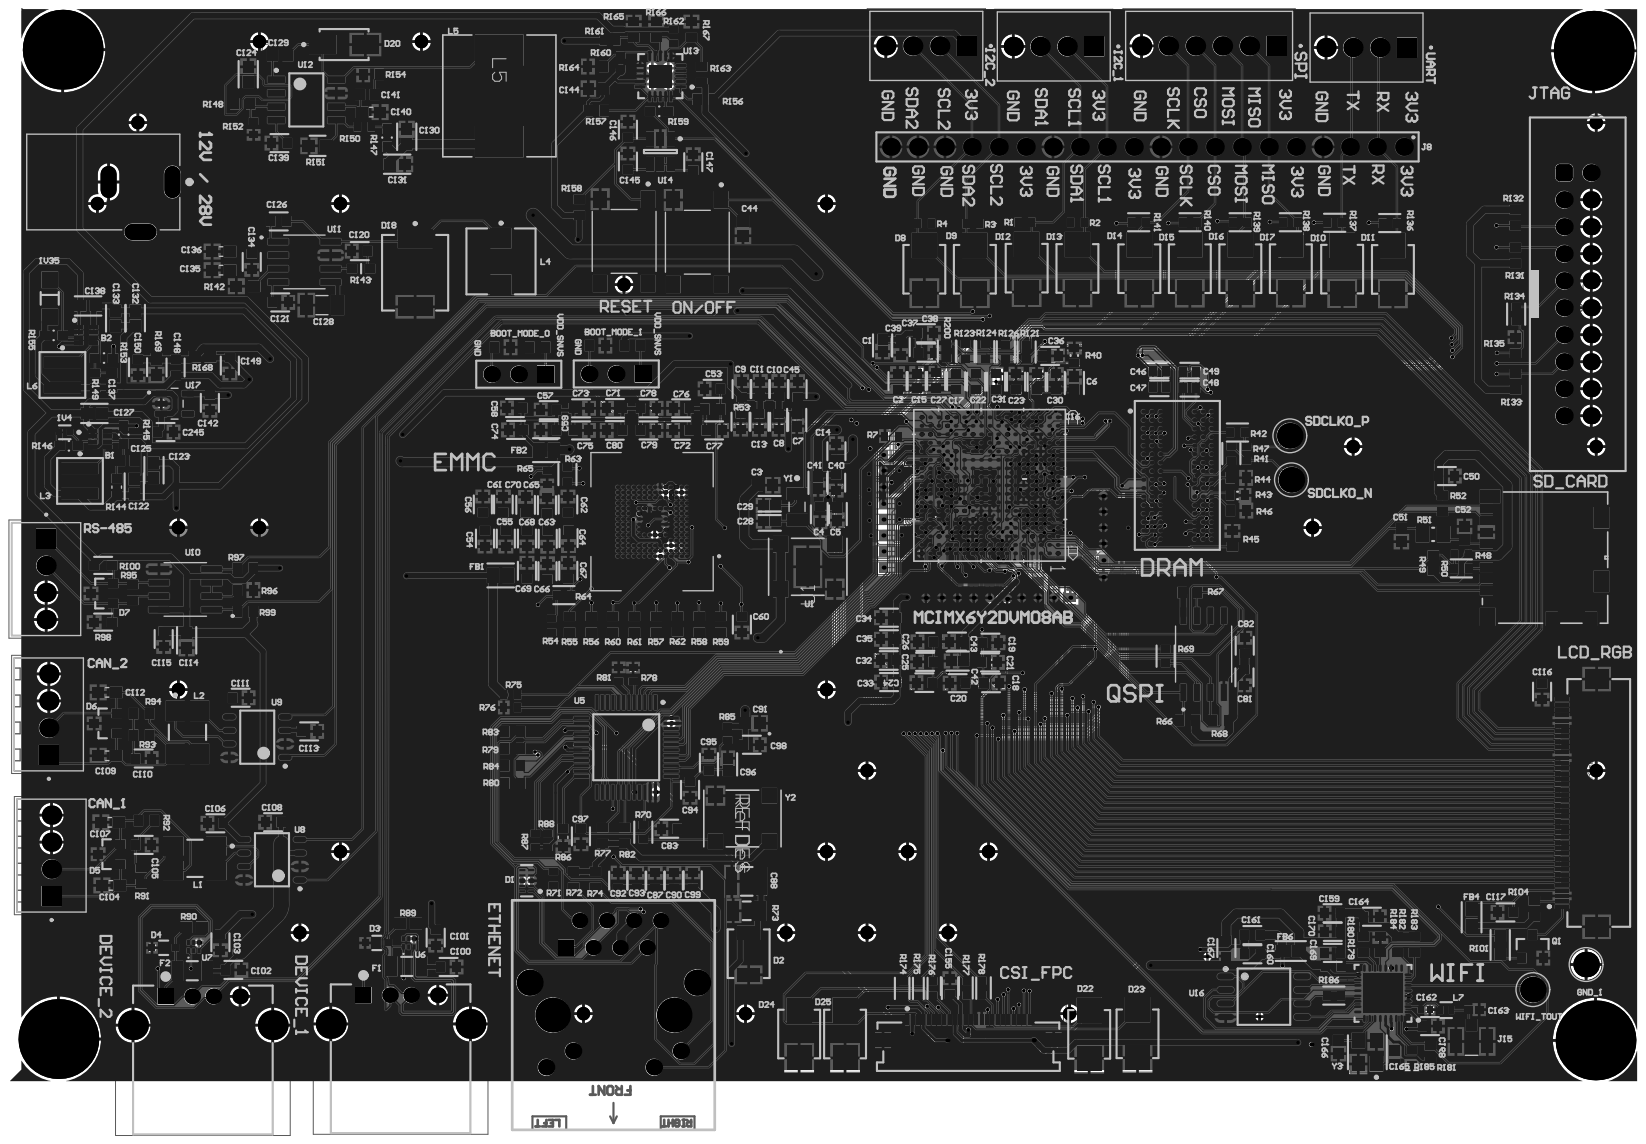
[picture p24: page 13]

10uF 220nF | CAP CER 10UF 10V X5R 0.22µF 50V Ceramic Capacitor X7R 0603 (1608 Metric) 0.063" L x 0.031" W (1.60mm x 0.80mm) | C1, C5, C6, C7, C28, C29, C41, C42, C96 C2, C4, C8, C9, C10, C11, C12, C13, C14, C15, C16, C17, C19, C20, C21, C22, C23, C25, C26, C27, C30, C31, C33, C34, C35, C36, C38, C39, C43, C45, C50 | FP-CC0603-DC-IPC_C FP-CC0603-DA-MFG | CMP-03422-001507-1 CMP-03422-001373-1 | 9 31

0.1 uF | Chip Capacitor, 100 nF, +/- 10%, 50 V, -55 to 125 degC, 0603 (1608 Metric), RoHS, Tape and Reel | C3, C129, C144 | CAPC1608X90X35ML1 0T15 | CMP-2006-02375-5 | 3

22uF | CAP CER 22UF 6.3V X5R 0603 | C18, C24, C32 | FP-CC0603-DC-MFG | CMP-2000-06075-2 | 3

4.7uF 100 nF | CAP CER 4.7UF 10V X5R 0603 CAP CER 0.1UF 50V X7R 0603 | C37, C56, C58, C82, C149 C40, C53, C54, C55, C57, C59, C63, C64, C65, C66, C67, C68, C69, C73, C74, C75, C76, C77, C78, C79, C81, C83, C87, C90, C92, C93, C94, C95, C97, C98, C99, C100, C102, C106, C108, C111, C113, C115, C116, C117, C126, C145, C147, C148, C150, C151, C154, C155, C159, C160, C164, C167, C168, C169, C170, C356 | FP-CC0603-DA-MFG | CMP-2000-06074-2 CMP-2100-03601-2 | 5 56

100 pF | Chip Capacitor, 100 pF, +/- 5%, 50 V, -55 to 125 degC, 0603 (1608 Metric), RoHS, Tape and Reel | C44, C91 | CAPC1608X90X40ML1 0T20 | CMP-2100-03594-1 | 2

2.2 pF 18 pF | Chip Capacitor, 18 pF, CAP CER 2.2PF 50V NP0 0603 +/- 5%, 50 V, -55 to 125 degC, 0603 (1608 Metric), RoHS, Tape and Reel | C46, C47, C48, C49 C51, C52 | FP-C0603C-CF-MFG CAPC1608X90X40NL10 T20 | CMP-1035-00158-3 CMP-1659-00030-1 | 4 2

2.2 uF 22 uF | CAP CER 2.2UF 10V X5R 0603 CAP CER 22UF 6.3V X5R 0603 | C60 C61, C62, C70, C71, C72, C80 | FP-CC0603-DA-MFG FP-CC0603-DC-MFG | CMP-2000-06073-2 CMP-2000-06075-2 | 1 6

4.7 nF | CAP CER 4700PF 2KV X7R 1210 | C88 | FP-C1210C472KGRAC780 0-MFG | CMP-03020-034683-2 | 1

1uF | 1UF 10V X5R 0603, CAP CER 1UF 10V X5R 0603 | C101, C103, C161 | FP-CC0603-DA-MFG | CMP-03422-000162-1 | 3

47 pF | 47 pF Â±5% 50V Ceramic Capacitor C0G, NP0 0603 (1608 Metric) | C104, C107, C109, C112 | CAPC1608X90 | CC0603JRNPO9BN470 | 4

4.7 nF 10 uF | CAP CER 4700PF 50V X7R 0603 Chip Multilayer Ceramic Capacitors for General Purpose, 0603, 10uF, X7R, 15%, 20%, 10V | C105, C110 C114, C122, C123, C124, C132, C133, C152, C153 | FP-CC0603-DA-MFG FP-GRM188-0_2-IPC_B | CMP-2100-03603-2 CMP-06035-036920-1 | 2 8

10 nF 120 pF | CAP CER 10000PF 50V X7R 0603 | C120, C121, C146 C125, C137 | FP-CC0603-DA-MFG CAPC1608X90X35NL10 T15 | CMP-2100-03600-2 CMP-2006-02605-1 | 3 2

4.7 uF | Multilayer Ceramic Capacitor 4.7uF 6.3V X7R 20% SMD 0603 T/R | C127, C138 | FP-0603-L_1_6_0_2-W_0_8_0-IPC_B | CMP-14477-004372-2 | 2

22 uF | 22 ÂµF Â±10% 10V Ceramic Capacitor X7R 1206 (3216 Metric) | C128 | CAPC3216X110N | C1206C226K8RACTU | 1

47uF | Chip Multilayer Ceramic Capacitors for General Purpose, 0603, 47uF, X5R, 15%, 20%, 6.3V | C130, C131 | FP-GRM188-0_2-IPC_B | CMP-2000-05444-2 | 2

10nF 47pF | CAP CER 10000PF 50V X7R 0603 47 pF Â±5% 50V Ceramic Capacitor C0G, NP0 0603 (1608 Metric) | C134, C139 C135, C136, C140 | FP-CC0603-DA-MFG CAPC1608X90 | CMP-2100-03600-2 CC0603JRNPO9BN470 | 2 3

1000 pF 1 uF | CAP CER 1UF 10V X5R 0603 | C141 C142, C245 | CAPC1608X90X35NL10 T15 FP-CC0603-DA-MFG | CMP-2006-02891-1 CMP-03422-000162-1 | 1 2

2.4 pF | SMD Capacitor C0G(EIA) with Capacitance: 2.4pF Tol. 0.05pF. Rated Voltage: 50Vdc | C162 | CAPC1005X55N | GRM1555C1H2R4WA0 1D | 1

3.0 pF 22 pF | Chip Capacitor, 22 pF, +/- 5%, 50 V, -55 to 125 degC, 0603 (1608 Metric), RoHS, Tape and Reel | C163 C165, C166 | CAPC1005X55X25ML0 5T10 CAPC1608X90X40NL10 T20 | CMP-1034-00237-2 CMP-1659-00026-1 | 1 2

TVS | TVS diode [Würth Elektronik] 824521751 TVS diode | D8, D9, D10, D11, D12, D13, D14, D15, D16, D17, D22, D23, D24, D25 | WE-TVSP_DO-214AA_Bidirectional | CMP-03913-71101643-2 | 14

SS34-E3/9AT B340A-13-F 1V4_SOC_IN 1V35_DRAM | DIODE SCHOTTKY 40V 3A DO214AB DIODE SCHOTTKY 40V LED RED DIFFUSED 0402 SMD LED GREEN DIFFUSED 1206 SMD 3A SMA | D18 D19 D21 D20 | FP-SMC-MFG FP-HSMC-C280-MFG FP-HSMG-C150-MFG FP-SMA-MFG | CMP-02539-000066-1 CMP-18399-000022-1 CMP-2000-05061-2 CMP-1667-00003-3 | 1 1

Fuse FB | PTC RESET FUSE 6V 500MA 1206 Chip Ferrite Bead, 0805, 2200Ω @ 100MHz, 0.6Ω, 25%, 200mA | F1, F2 FB1, FB2 | FP-1206L050YR-MFG FP-BLM21-0_2-t0_85-e0_5-IPC_C | CMP-08606-000073-1 CMP-0686-00653-3 | 2 2

BLM18PG121SN1D | Chip Ferrite Bead, 0603, 120Ω @ 100MHz, 0.05Ω, 25%, 2A | FB4 | FP-BLM18-0_15-t0_8-IPC_A | CMP-0686-00557-7 | 1

FB | Chip Ferrite Bead, 0603, 1500Ω @ 100MHz, 0.5Ω, 25%, 500mA | FB6 | FP-BLM18-0_15-t0_8-IPC_A | CMP-0686-00368-3 | 1

1040310811 292303-1 | 1 Port Right Angle Through Hole Mount Female Type A USB Connector, 4 Position, -55 to 85 degC, RoHS, Tube | J1 J2, J3 | 104031-0811_MOL TE-292303-1_V | 1040310811 CMP-2000-05404-1 | 1 2

TEST POINT (BLUE) -COMPACT | GND, SDCLK0_N, SDCLK0_P, WIFI_TOUT | KEYSTONE_5277 | 5277 | 4

TB CAN_1 | Conn; Term Blk; PCB; Wire Receptacle; 4; 2.54mm; 30-16AWG; Green; 10A;150V; M1.6 | TE Connectivity 282834-4 | J4 | TE_282834-4 | 282834-4 | 1

TB CAN_2 | Conn; Term Blk; PCB; Wire Receptacle; 4; 2.54mm; 30-16AWG; Green; 10A;150V; M1.6 | TE Connectivity 282834-4 | J5 | TE_282834-4 | 282834-4 | 1

TB RS-485 | Conn; Term Blk; PCB; Wire Receptacle; 4; 2.54mm; 30-16AWG; Green; 10A;150V; M1.6 | TE Connectivity 282834-4 | J6 | TE_282834-4 | 282834-4 | 1

FH12-40S-0.5SH(55) | CONN FFC BOTTOM 40POS 0.50MM R/A | J7 | FP-FH12-40S-0_5SH_55-MFG | CMP-2000-06267-2 | 1

Global Header TB UART | 20 pins, 1 row, straight, gold plating Conn; Term Blk; PCB; Wire Receptacle; 4; 2.54mm; 30-16AWG; Green; 10A;150V; M1.6 | TE Connectivity 282834-4 | J8 J9 | 61302011121 TE_282834-4 | 6130XX11121_613020 11121 282834-4 | 1 1

TB I2C2 | Conn; Term Blk; PCB; Wire Receptacle; 4; 2.54mm; 30-16AWG; Green; 10A;150V; M1.6 | TE Connectivity 282834-4 | J10 | TE_282834-4 | 282834-4 | 1

TB SPI | Conn; Term Blk; PCB; Wire Receptacle; 6; 2.54mm; 30-16AWG; Green; 10A;150V; M1.6 | TE Connectivity 282834-6 | J11 | TE_282834-6 | 282834-6 | 1

TB I2C1 | Conn; Term Blk; PCB; Wire Receptacle; 4; 2.54mm; 30-16AWG; Green; 10A;150V; M1.6 | TE Connectivity 282834-4 | J12 | TE_282834-4 | 282834-4 | 1

PJ-102AH | 2.0 x 6.5 mm, 5.0 A, Horizontal, Through Hole, Tapered Pins, Dc Power Jack Connector | J13 | CUI_PJ-102AH | PJ-102AH | 1

54548-2471 | 0.5 mm Pitch Easy-On(TM) Type FPC Connector, 1.2 mm Mated Height, Right Angle, ZIF, SMT, Bottom Contact, 24 Circuits, -20 to 85 degC, ELV and RoHS Compliant, Tape and Reel | J14 | MOLX-54548-2471 | CMP-1241-00556-1 | 1

1909763-1 B82789C0513N002 470 nH | CMC 51UH 250MA 2LN SMD AEC-Q200 Surface Mount Power Inductor, XFL4015 Series, 470 nH, 20%, Shielded, 8360 ohm, 11.2 A | J15 L1, L2 L3, L6 | TE_1909763-1 FP-B82789C0513N002-0 FP-XFL4015-MFG | 1909763-1 CMP-10467-000006-1 CMP-11268-000114-1 | 1 2 2

7447785004 | General Purpose Inductor, 4.7uH, 25%, 1 Element, Ferrite-Core, SMD, 2423 | L4 | WE-PD_6033R | CMP-0227-00287-3 | 1

6.8 uH | Power Inductors - SMD 6.8uH 20% 23.21mOhms AEC-Q200 | L5 | IND_SPM10054T_TDK | SPM10054T-6R8M-HZR | 1

2.2 nH | Wire Wound RF Inductor 2.2nH ±2% 2530mA 0.022Ω 0402 (1005) | L7 | FP-LQW15AN_80-MFG | CMP-06042-014713-1 | 1

61202021621 | WR-BHD Straight Male, Box Header, Through Hole, 2 Rows, 20 Contacts, 2.54mm Pitch | P1 | 61202021621 | CMP-1502-00010-3 | 1

TSW-103-07-G-S | 0.025" SQ Post Header, Through-hole, Vertical, -55 to 125 degC, 2.54 mm Pitch, 3-Pin, Male, RoHS | P2, P3 | SMTC-TSW-103-07-X-S | CMP-1024-00333-1 | 2

N-MOSFET 4.7 kΩ | MOSFET N-CH 60V Chip Resistor, 4.7 KOhm, +/- 1%, 0.1 W, -0.3A SOT23 55 to 155 degC, 0603 (1608 Metric), RoHS, Tape and Reel | Q1 R1, R2, R3, R4, R48, R54 | FP-PG-SOT23-3-MFG RESC1608X55X25LL10 T15 | CMP-32901-000180-1 CMP-2000-06942-1 | 1 6

10 kΩ | Resistor, 10 KOhm, +/-5%, 100 mW, -55 to 155 degC, 0603 (1608 Metric), RoHS, Tape and Reel | R5, R6, R8, R9, R10, R11, R12, R13, R14, R15, R16, R17, R18, R19, R20, R21, R22, R23, R24, R25, R26, R27, R28, R29, R49, R52, R53, R55, R56, R57, R58, R59, R60, R61, R62, R66, R67, R68, R77, R96, R97, R99, R131, R132, R133, R135, R156, R157, R158, R164, R165, R166, R167, R170, R171, R172, R173, R179, R180, R181, R182, R183, R184 | RESC1608X55X25ML10 T15 | CMP-2000-05022-1 | 63

4.7K | Chip Resistor, 4.7 KOhm, +/- 1%, 0.1 W, -55 to 155 degC, 0603 (1608 Metric), RoHS, Tape and Reel | R7 | RESC1608X55X25LL10 T15 | CMP-2000-06942-1 | 1

240 Ω , 1% 22 Ω | 240R 0.1W 1% 0603 (1608 Metric) SMD RES SMD 22 OHM 5% 1/10W 0603 | R40, R43 R41, R42, R50, R63, R64, R69, R70, R102, R103, R105, R106, R107, R108, R109, R110, R111, R112, R113, R114, R115, R116, R117, R118, R119, R120, R121, R122, R123, R124, R125, R126, R127, R128, R129, R130, R134, R136, R137, R138, R139, R140, R141, R174, R175, R176, R177, R178, R186, R200 | RESC0603(1608)_L FP-RC0603-0_55-IPC_C | CMP-1012-00438-1 CMP-03412-037819-1 | 2 49

10 kΩ ±5% | Resistor, 10 KOhm, +/-5%, 100 mW, -55 to 155 degC, 0603 (1608 Metric), RoHS, Tape and Reel | R44, R45, R46 | RESC1608X55X25ML10 T15 | CMP-2000-05022-1 | 3

470 Ω | General Purpose Chip Resistor, 470 Ohm, +/-1%, -55 to 155 degC, 0603 (1608 Metric), RoHS, Tape and Reel | R47 | RESC1608X55X25LL10 T15 | CMP-1659-00035-2 | 1

10 Ω | Chip Resistor, 10 Ohm, +/- 1%, 0.125 W, -55 to 155 degC, 0805 (2012 Metric), RoHS, Tape and Reel | R51 | RESC2013X60X35ML10 T20 | CMP-2100-03670-1 | 1

47 k | | R65 | RESC1608X55X25LL10 T15 | CMP-2000-04221-1 | 1

2.2 kΩ | Thick Film Resistor, 2.2 KOhm, 100 mW, 50 V, +/- 1%, -55 to 155 degC, 2-Pin SMD (0603), RoHS, Tape and Reel | R71, R75, R76, R78, R81, R85, R87, R88 | RESC1608X55X25LL10 T15 | CMP-2000-06934-1 | 8

330 Ω | Chip Resistor, 330 Ohm, +/- 1%, 0.1 W, -55 to 155 degC, 0603 (1608 Metric), RoHS, Tape and Reel | R72, R74 | RESC1608X55X25ML10 T15 | CMP-1659-00020-2 | 2

1 MΩ | RES Thick Film, 1MΩ, 1%, 0.25W, 100ppm/°C, 1206 | R73 | FP-CRCW1206-e3-MFG | CMP-2003-01906-2 | 1

49.9Ω | General Purpose Chip Resistor, 49.9 Ohm, +/-1%, -55 to 155 degC, 0603 (1608 Metric), RoHS, Tape and Reel | R79, R80, R83, R84 | RESC1608X55X25ML10 T15 | CMP-1659-00036-1 | 4

1.5 kΩ | Chip Resistor, 1.5 KOhm, +/- 1%, 0.1 W, -55 to 155 degC, 0603 (1608 Metric), RoHS, Tape and Reel | R82 | RESC1608X55X25ML10 T15 | CMP-2100-03665-1 | 1

4.87 kΩ | 4.87 kOhms Â±1% 0.1W, 1/10W Chip Resistor 0603 (1608 Metric) Moisture Resistant Thick Film | R86 | RESC1608X55N | RC0603FR-074K87L | 1

1 kΩ | 1 kOhms Â±1% 0.1W, 1/10W Chip Resistor 0603 (1608 Metric) Moisture Resistant Thick Film | R89, R90 | RESC1607X60N | RC0603FR-071KL | 2

60 Ω 120Ω | Chip Resistor, 120 Ohm, +/- 1%, 100 mW, -55 to 155 degC, 0603 (1608 Metric), RoHS, Tape and Reel | R91, R92, R93, R94 R95 | RESC1608X55X25ML10 T15 | CMP-2000-04100-1 CMP-1659-00034-1 | 4 1

20 kΩ | RES SMD 20K OHM 1% 1/10W 0603 | R98, R100 | FP-RT0603-MFG | CMP-2000-04684-2 | 2

7.5 Ω 100 Ω 86.6 kΩ | 86.6 kOhms Â±1% 0.1W, 1/10W Chip Resistor 0603 (1608 Metric) Moisture Resistant Thick Film | R104 R101 R142 | RESC1608X55X25ML10 T15 FP-RC0603-0_55-IPC_A 0603 | CMP-2000-04140-1 CMP-2100-03663-2 RC0603FR-0786K6L | 1 1 1

10 kΩ 133 kΩ | RES 10K OHM 1% 1/10W 0603 0.1W, 1/10W Chip Resistor 0603 (1608 133 kOhms Â±1% Metric) Moisture Resistant Thick Film | R143 R144 | FP-RC0603-0_55-MFG RESC1608X55N | CMP-2100-03664-2 RC0603FR-07133KL | 1 1

100 kΩ 0Ω 332 kΩ | RES SMD 100K OHM JUMPER 1/10W 0603 RES SMD 0 OHM 1% 1/10W 0603 Chip Resistor, 332 KOhm, +/- 1%, 0.1 W, -55 to 155 degC, 0603 (1608 Metric), RoHS, Tape and Reel | R145, R146, R153, R147, R159 R155 R148 | FP-RC0603-MFG FP-RC0603-0_55-MFG RESC1608X55X25ML10 T15 | CMP-2000-06925-2 CMP-2100-03662-2 CMP-1659-00021-2 | 2 4 1

124 kΩ 10.2 kΩ | Chip Resistor, 10.2 KOhm, +/- 1%, 0.1 W, -55 to 155 degC, 0603 (1608 Metric), RoHS, Tape and Reel | R149 R150 | RESC1608X55X25NL10 T15 RESC1608X55X25LL10 T15 | CMP-2000-04894-1 CMP-2000-06926-1 | 1 1

3.24 kΩ | RES Thick Film, 3.24kΩ, 1%, 0.1W, 100ppm/°C, 0603 | R151 | FP-CRCW0603-e3-IPC_A | CMP-2000-03299-2 | 1

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
