aelbouhi0131-lang/BETABAKE_REV1.0/(list of files, drawings)

Other design files:
PCB/BetaBake_REV_1.0.PcbDoc
PCB/Copy before routing of BetaBake..PcbDoc
SCHEMATICS/01_CPU_Core.SchDoc
SCHEMATICS/02_DDR3L.SchDoc
SCHEMATICS/03_Boot_Memory.SchDoc
SCHEMATICS/04_Ethernet.SchDoc
SCHEMATICS/05_USB.SchDoc
SCHEMATICS/06_CAN_RS485.SchDoc
SCHEMATICS/07_Display_LCD.SchDoc
SCHEMATICS/08_Debug.SchDoc
SCHEMATICS/09_Power.SchDoc
SCHEMATICS/10_Boot_Cfg.SchDoc
SCHEMATICS/11_CSI.SchDoc
SCHEMATICS/12_WIFI.SchDoc
