aelbouhi0131-lang/BETABAKE_REV1.0/(commit log)

2026-10-13 Revise schematics section in README
    Updated the schematics section to include new files and reorder existing ones.
2026-10-13 Fix formatting of SCHEMATICS section in README
